npgo22/ThermoBoard/output/ThermoBoard.png

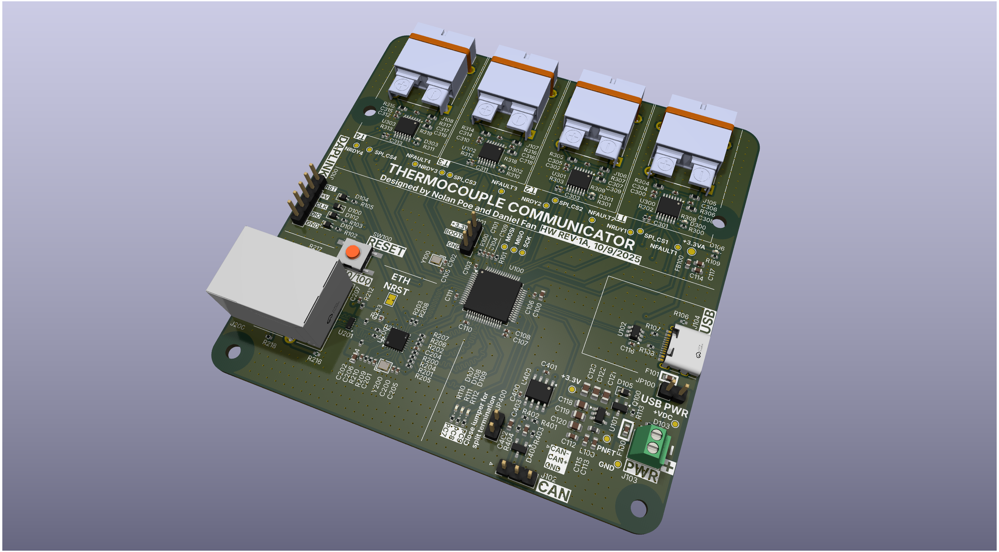
output/ThermoBoard.png
