npgo22/ThermoBoard/README

STATUS:
Initial decent layout and schematic are complete. PCB meets basic requirements.

TODO:
- Further review
