npgo22/ThermoBoard/output/ThermoBoard__Assembly.pdf

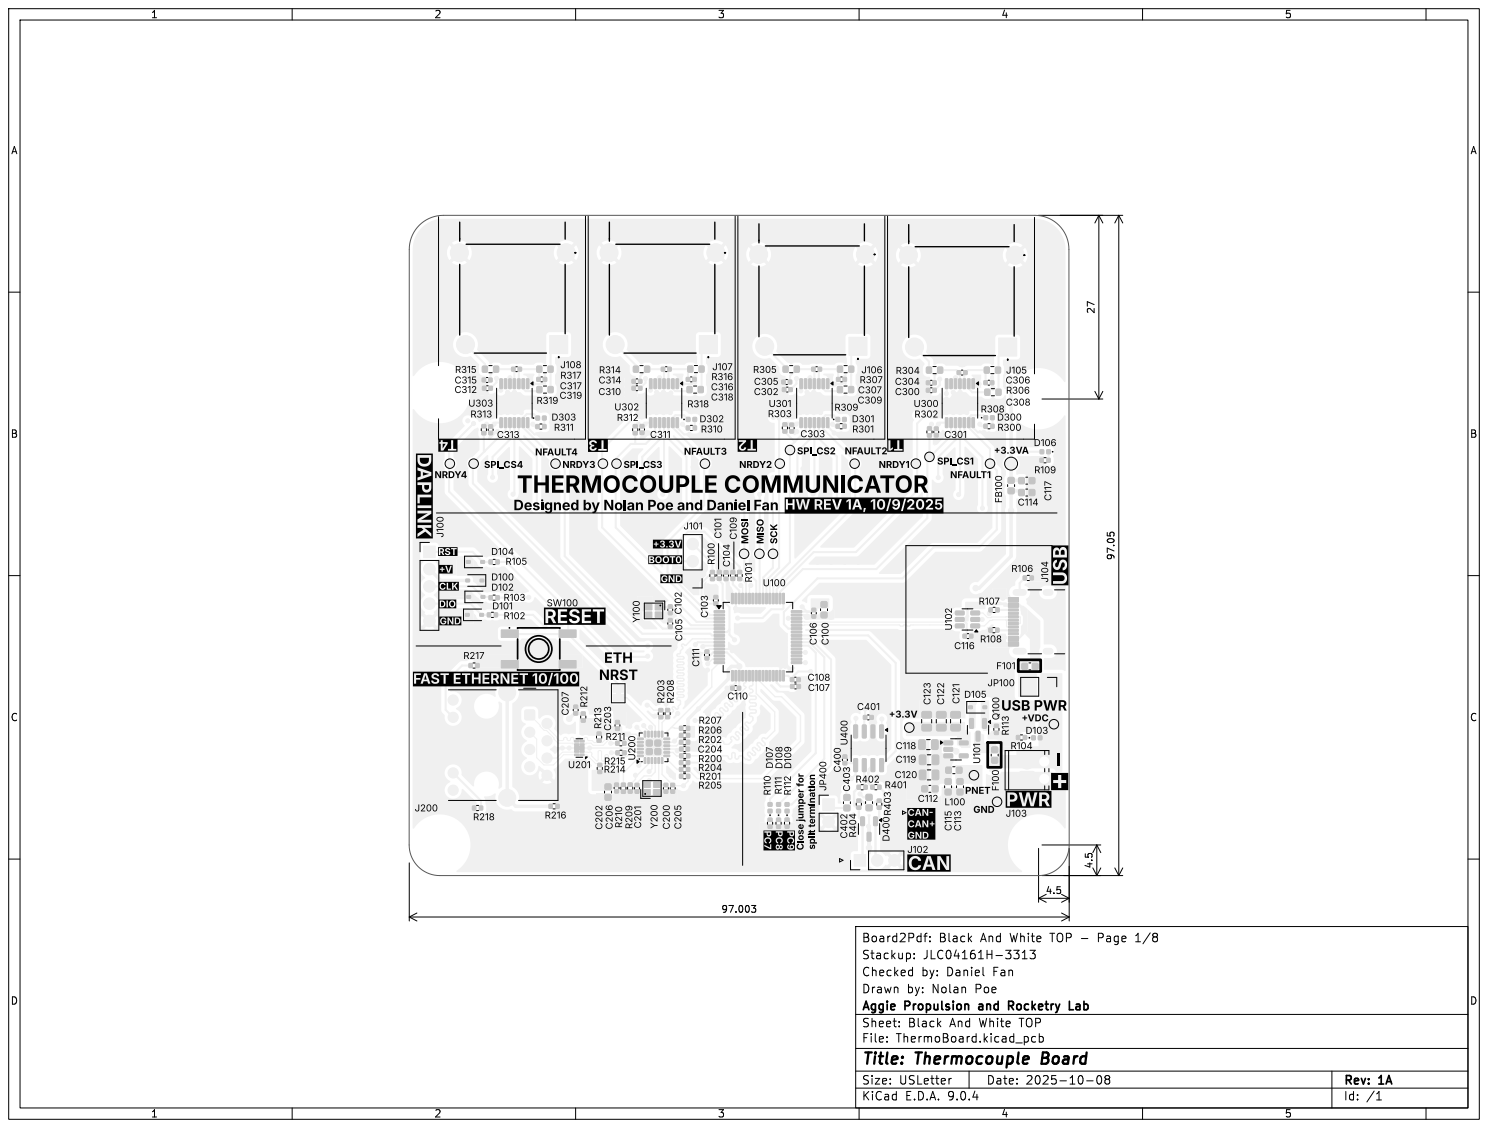
[picture p2: page 1]

THERMOCOUPLE COMMUNICATOR
Designed by Nolan Poe and Daniel Fan

+3.3V Close jumper for split termination

Id: /1 Title: Thermocouple Board

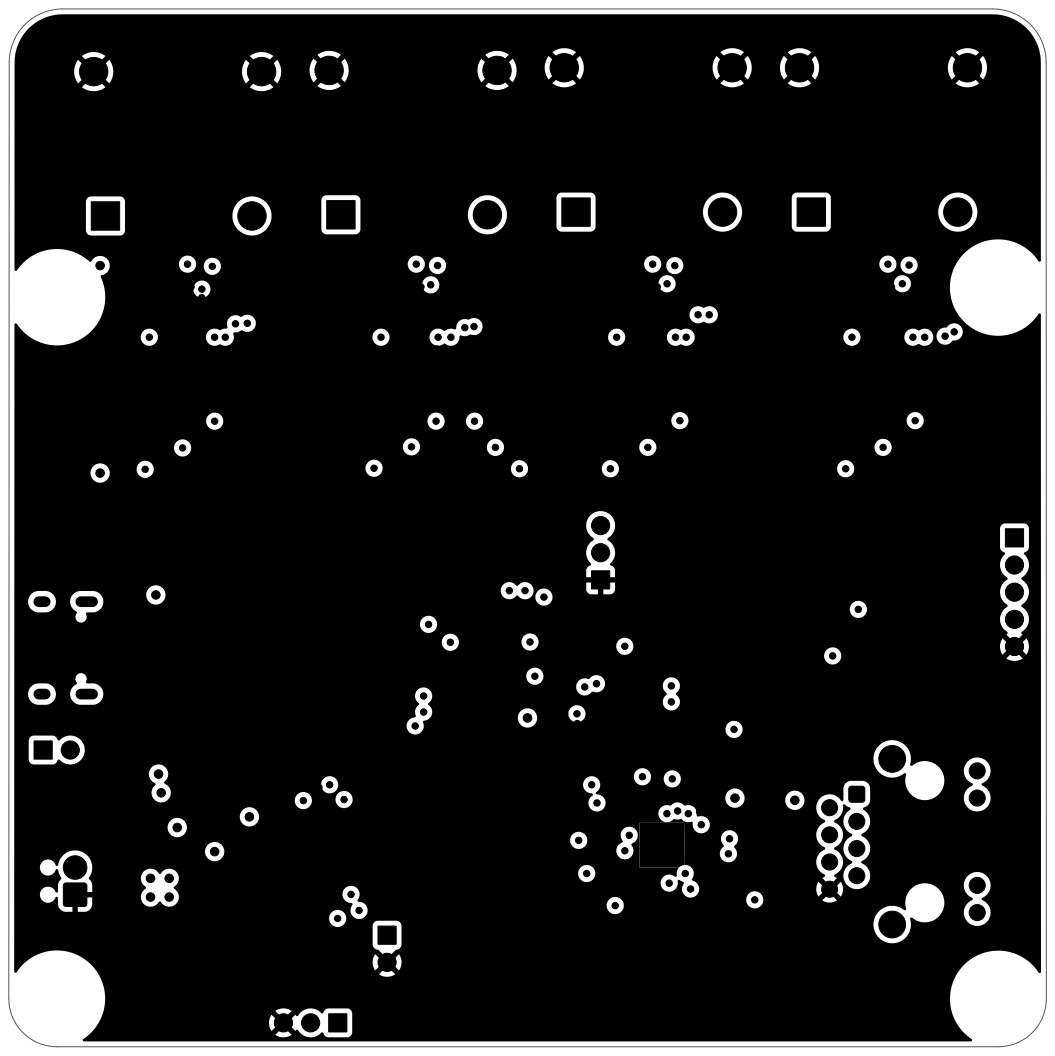
[picture p3: page 2]
D Date: 2025-10-08 KiCad; E.D.A. 9.0.4 Size: USLetter; Rev: 1A; File: ThermoBoard.kicad_pcb Sheet: Black; And; White; In1 Aggie; Propulsion and; Rocketry; Lab Drawn; Nolan; Poe Checked; Daniel; Fan Stackup:; JLC04161H-3313 Board2Pdf:; Black; Page 2/8

Id: /1 Title: Thermocouple Board

Id: /1 Title: Thermocouple Board

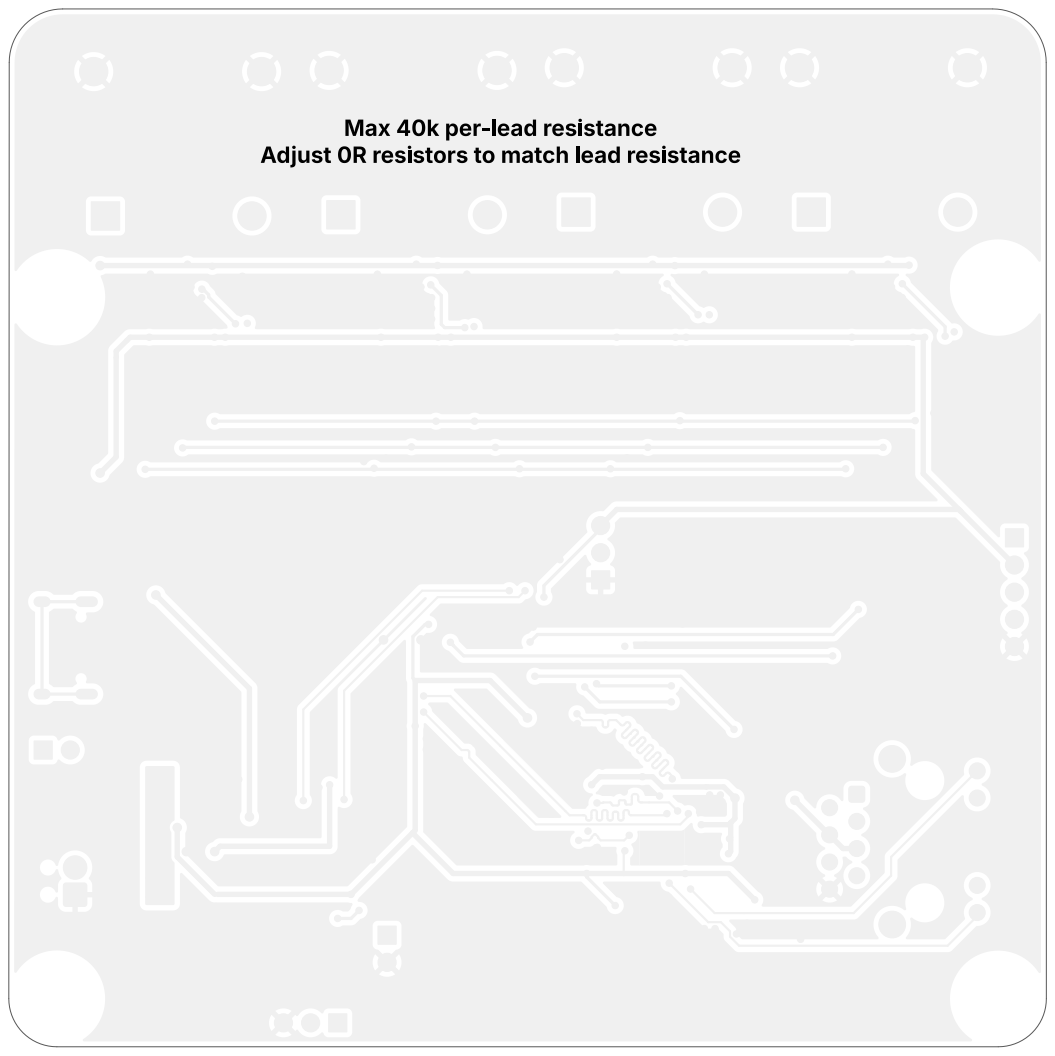
[picture p4: page 4]
D Date: 2025-10-08 KiCad; E.D.A. 9.0.4 Size: USLetter; Rev: 1A; File: ThermoBoard.kicad_pcb Sheet: Black; And; White; BOT Aggie; Propulsion and; Rocketry; Lab Drawn; Nolan; Poe Checked; Daniel; Fan Stackup:; JLC04161H-3313 Board2Pdf:; Black; BOT -; Page 4/8 Max 40k per-lead resistance; Adjust 0R resistors to match; lead resistance

Id: /1 Title: Thermocouple Board

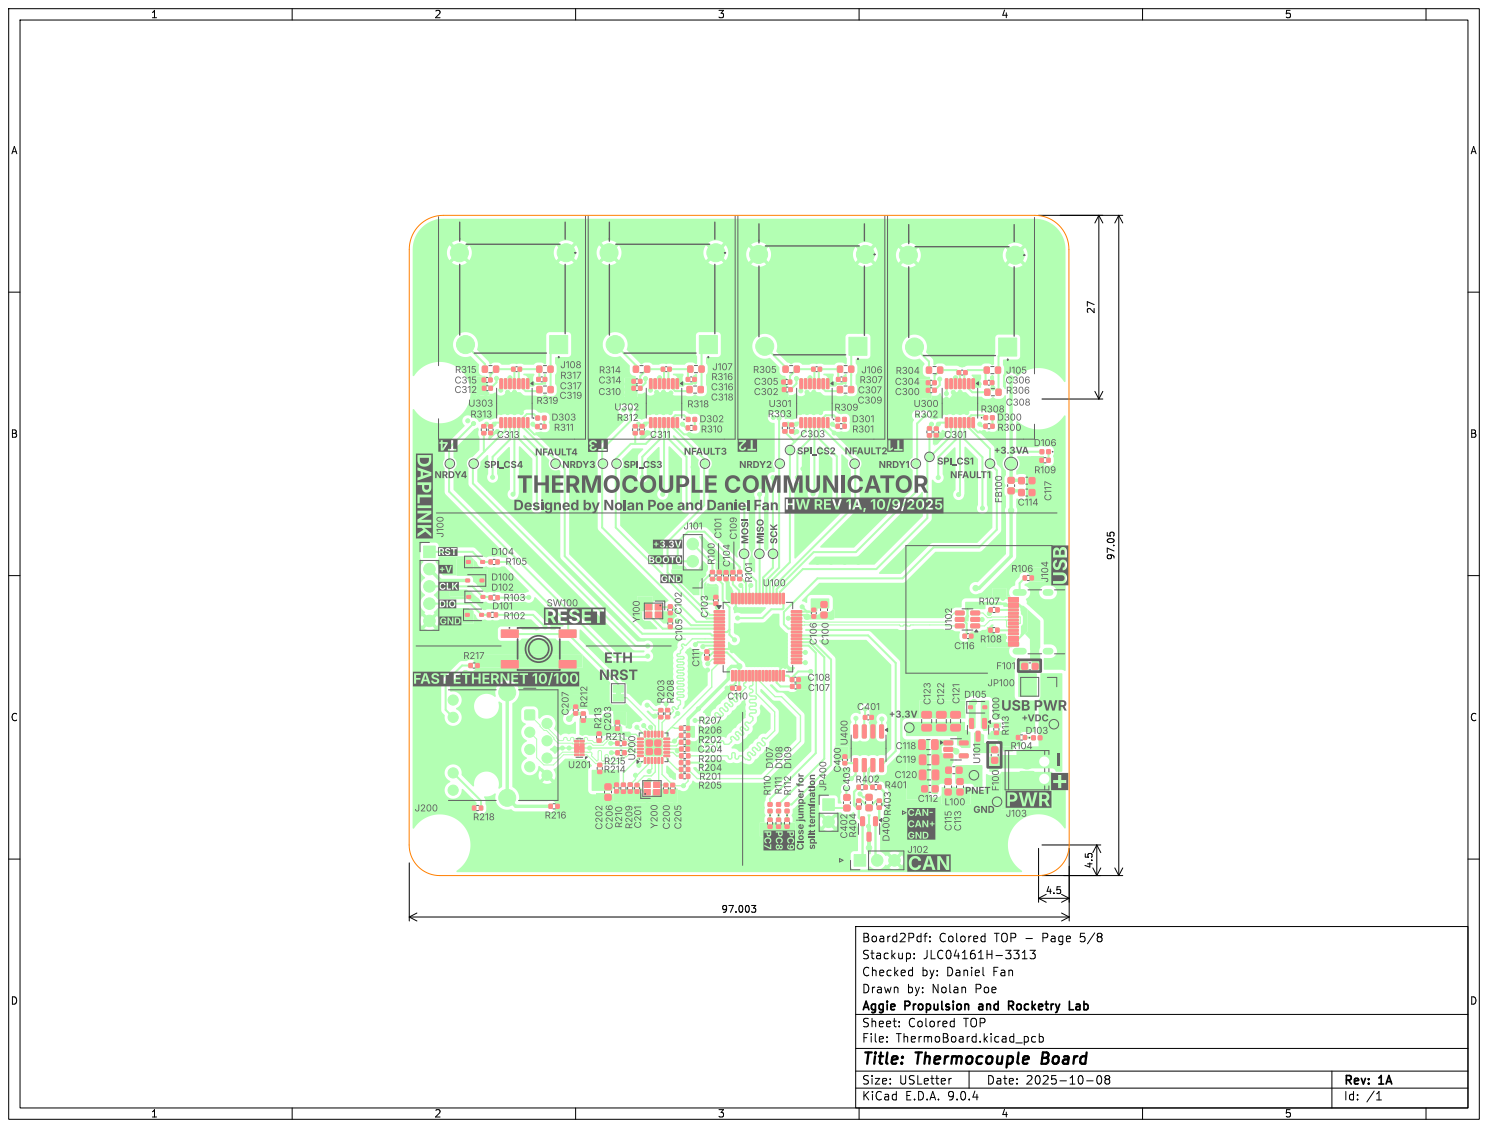
[picture p5: page 5]

THERMOCOUPLE COMMUNICATOR
Designed by Nolan Poe and Daniel Fan

+3.3V Close jumper for split termination

Id: /1 Title: Thermocouple Board

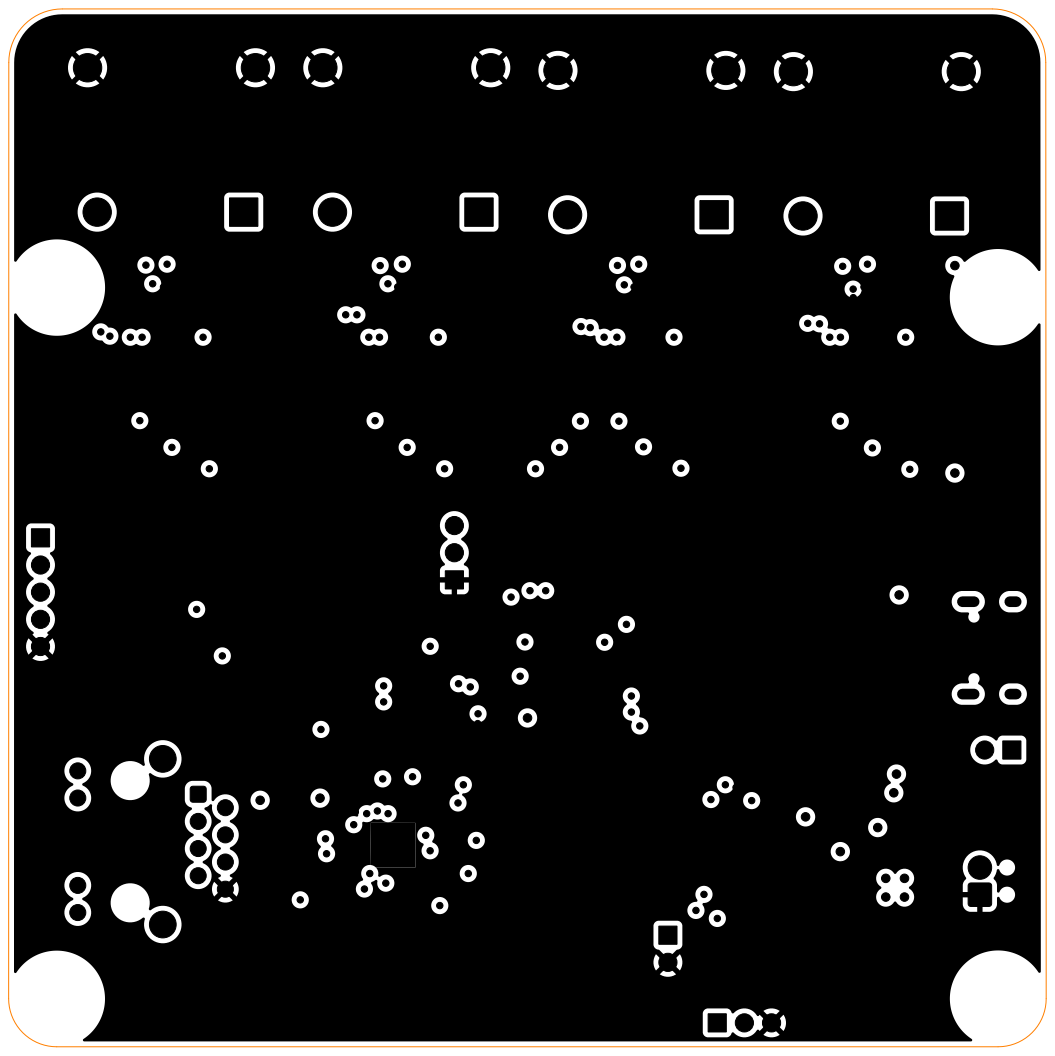
[picture p6: page 6]
D Date: 2025-10-08 KiCad; E.D.A. 9.0.4 Size: USLetter; Rev: 1A; File: ThermoBoard.kicad_pcb Sheet: Colored; In1 Aggie; Propulsion and; Rocketry; Lab Drawn; Nolan; Poe Checked; Daniel; Fan Stackup:; JLC04161H-3313 Board2Pdf:; Colored; Page 6/8

Id: /1 Title: Thermocouple Board

Id: /1 Title: Thermocouple Board

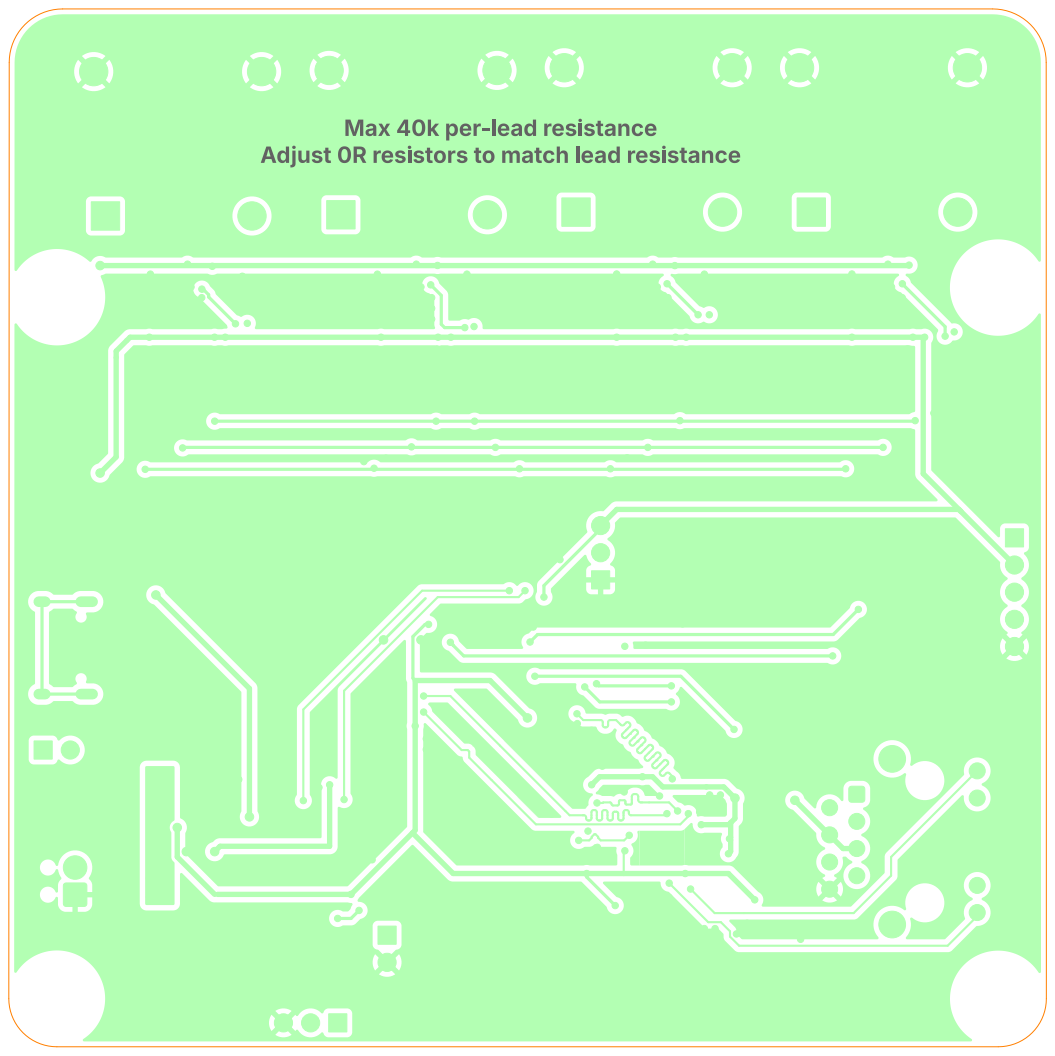
[picture p7: page 8]
D Date: 2025-10-08 KiCad; E.D.A. 9.0.4 Size: USLetter; Rev: 1A; File: ThermoBoard.kicad_pcb Sheet: Colored; BOT Aggie; Propulsion and; Rocketry; Lab Drawn; Nolan; Poe Checked; Daniel; Fan Stackup:; JLC04161H-3313 Board2Pdf:; Colored; BOT -; Page 8/8 Max 40k per-lead resistance; Adjust 0R resistors to match; lead resistance

Id: /1 Title: Thermocouple Board
