npgo22/ThermoBoard/output/ThermoBoard.pdf

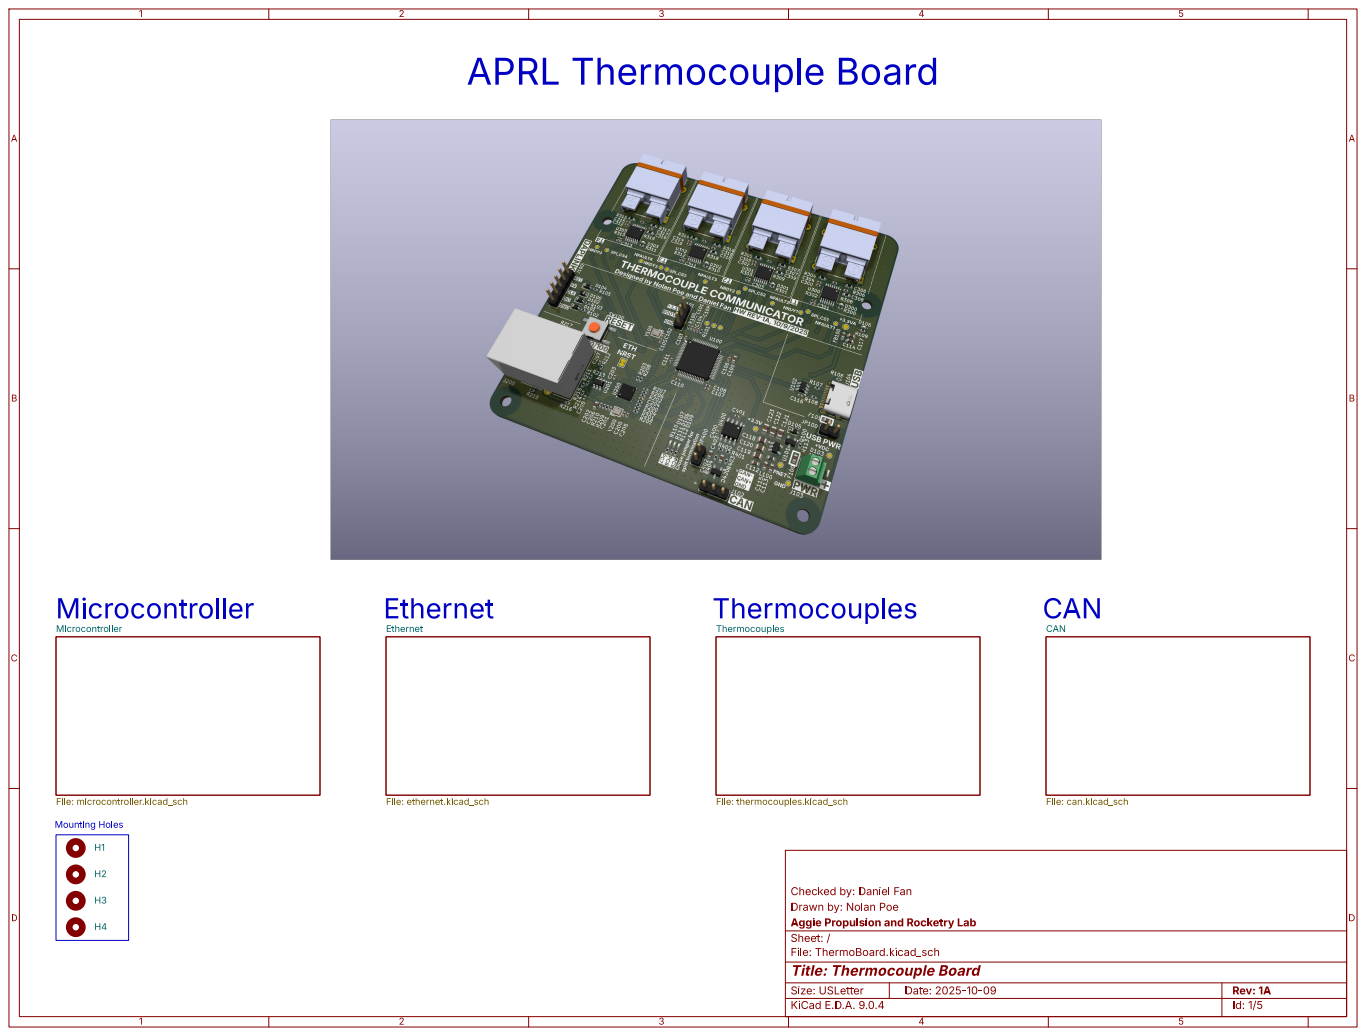
[picture p8: page 1]

Id: 1/5 Title: Thermocouple Board

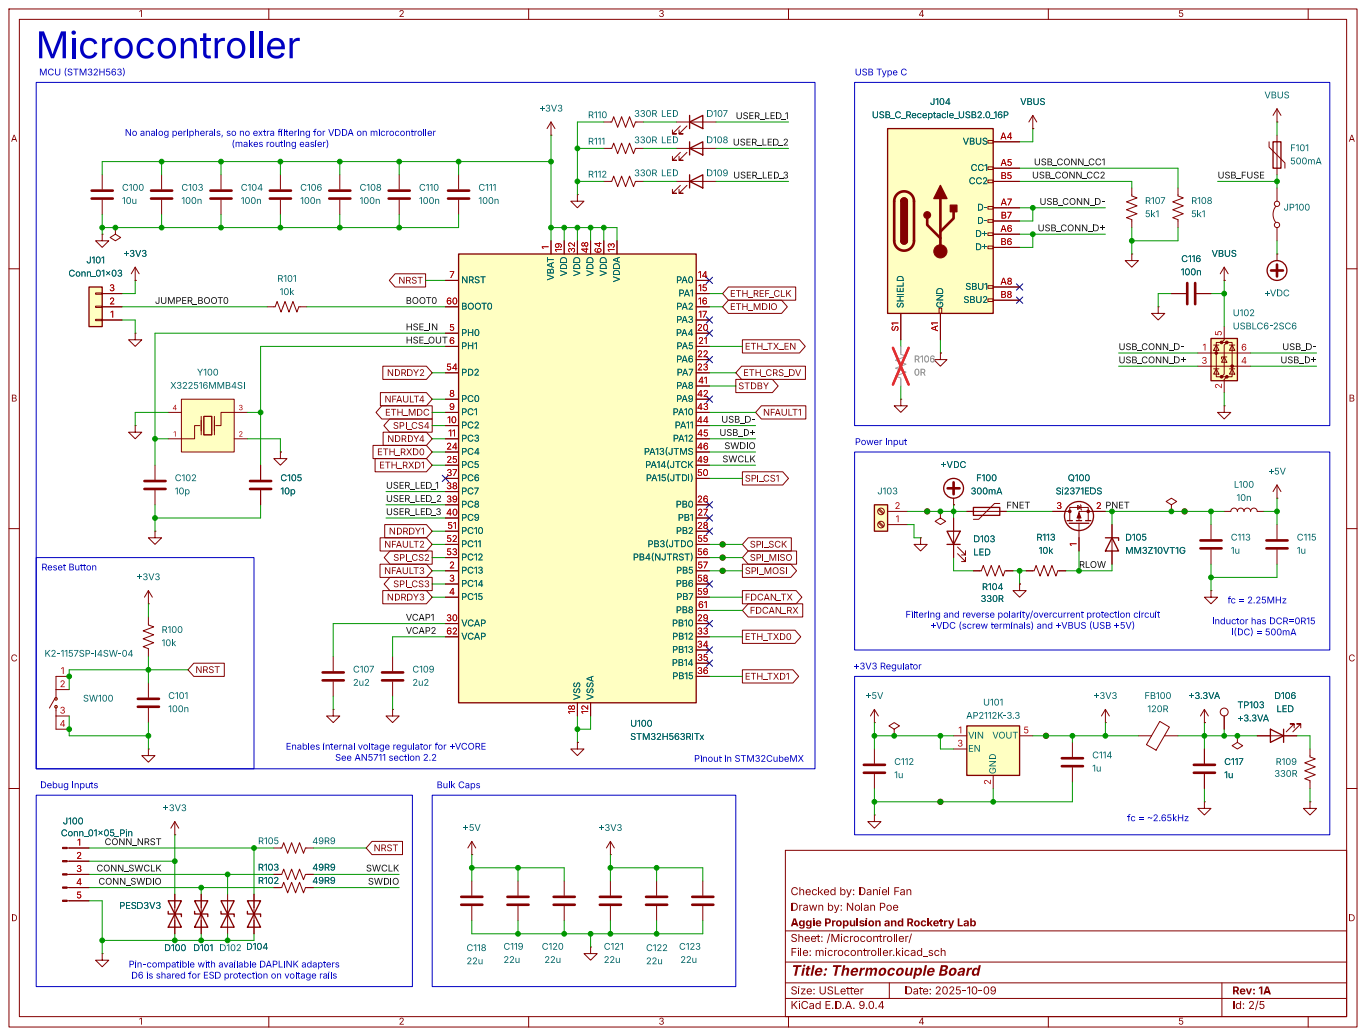
[picture p9: page 2]

No analog peripherals, so no extra filtering for VDDA on microcontroller

1 VDD 19 VDD 32 VSS 18 VDD 48 VSSA 12 VDD 64 VDDA 13 PA0

Power Input Reset Button Debug Inputs

Filtering and reverse polarity/overcurrent protection circuit +VDC (screw terminals) and +VBUS (USB +5V) Enables internal voltage regulator for +VCORE

Pin-compatible with available DAPLINK adapters D6 is shared for ESD protection on voltage rails

Id: 2/5 Title: Thermocouple Board

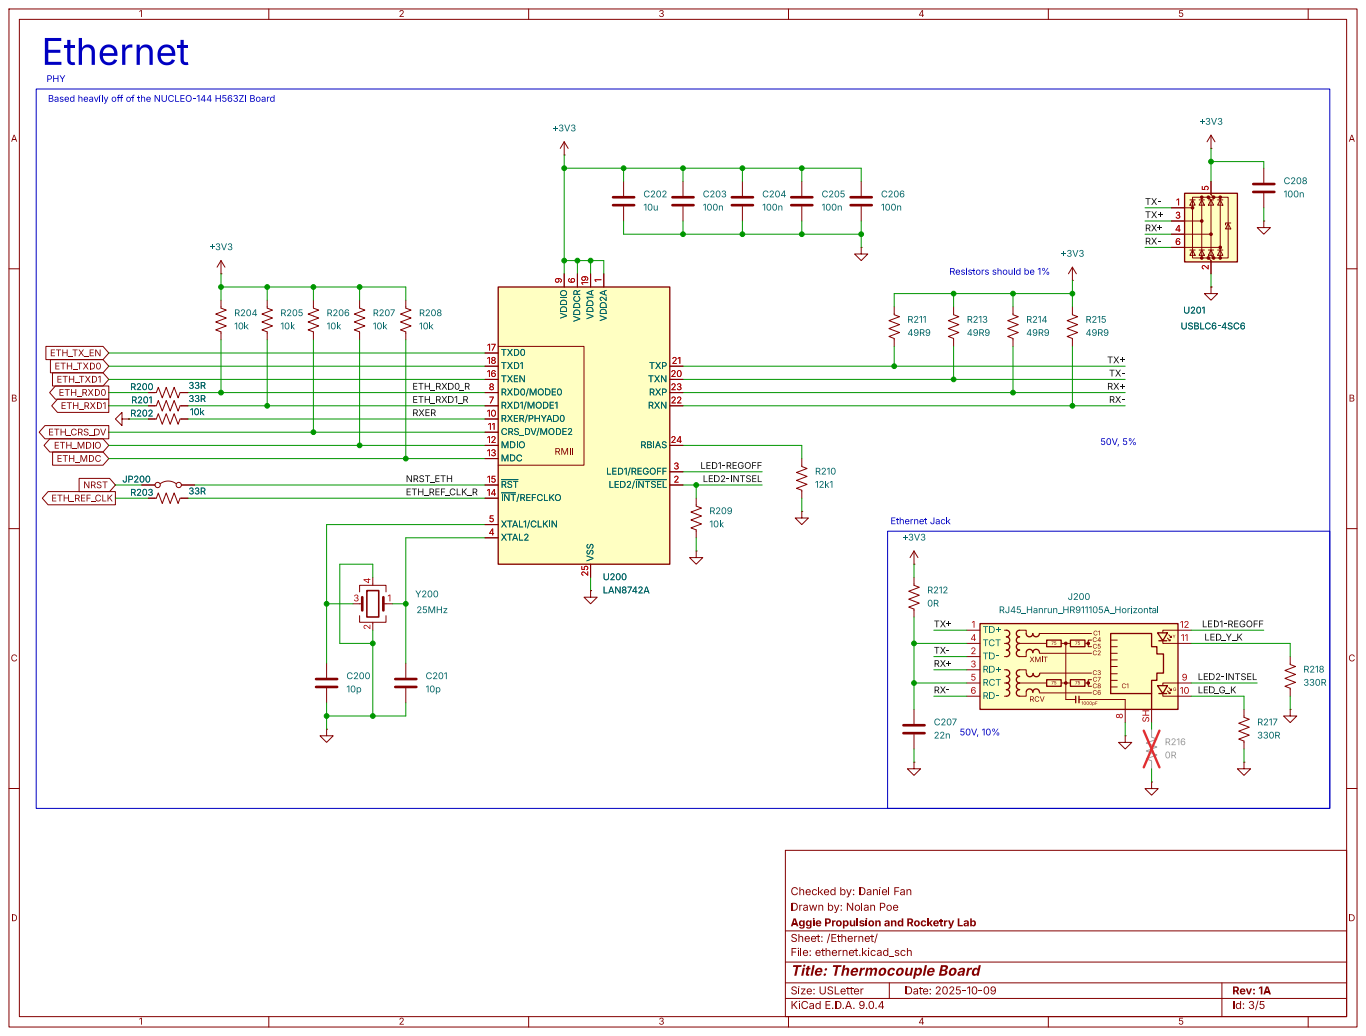
[picture p10: page 3]

Based heavily off of the NUCLEO-144 H563ZI Board

21 TXN
20 RXP 20 RXP 23 RXN 23 RXN

Id: 3/5 Title: Thermocouple Board

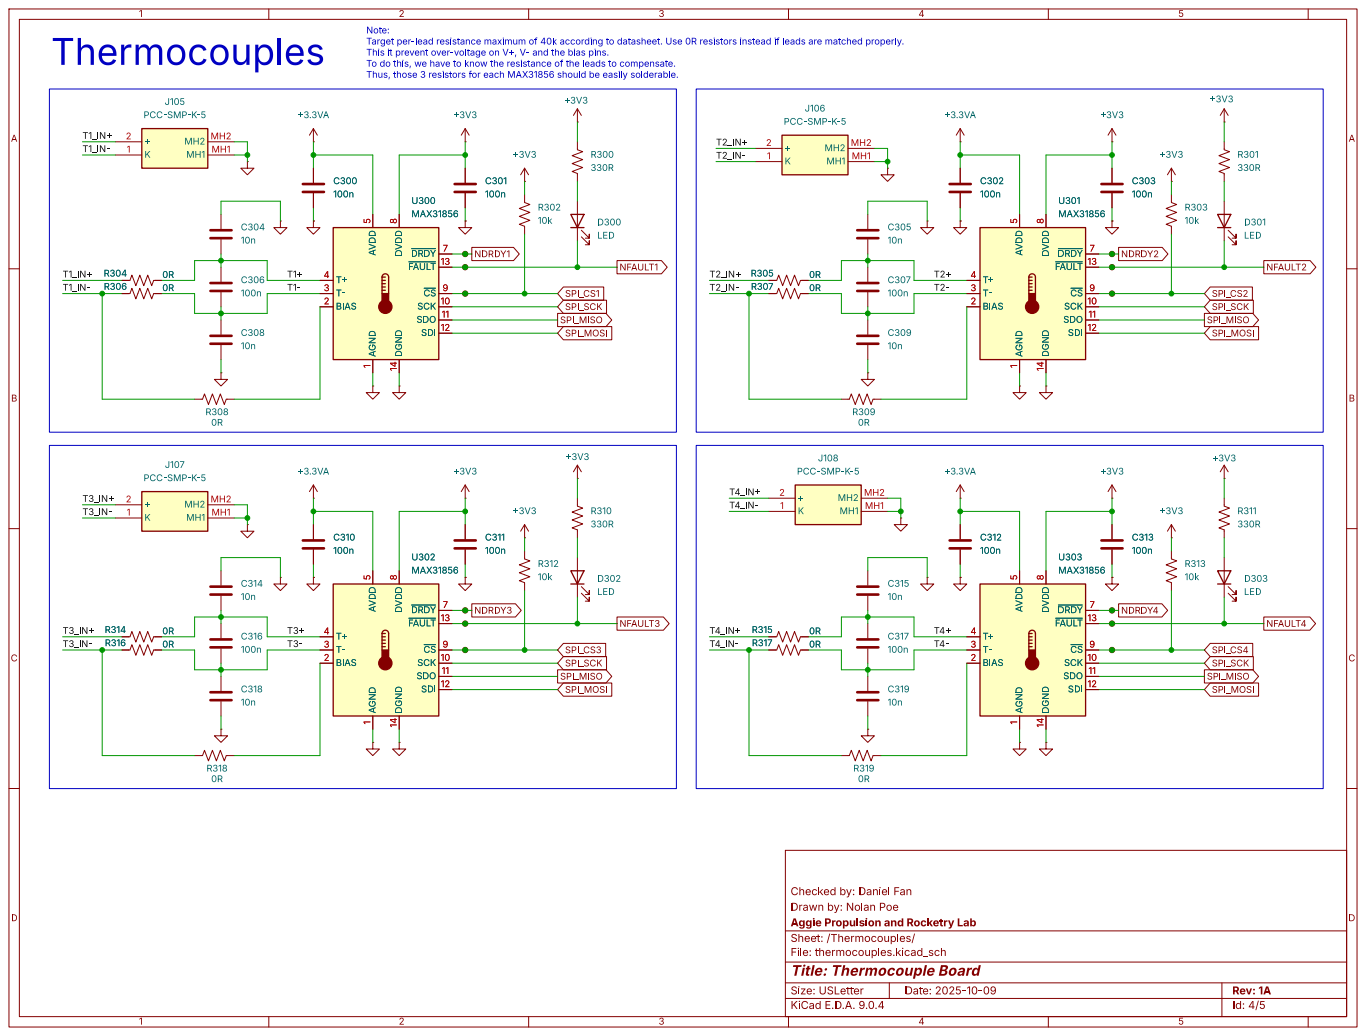
[picture p11: page 4]

~{DRDY}7 ~{FAULT} 13 ~{CS}9 SCK

File: thermocouples.kicad_sch Sheet: /Thermocouples/
Id: 4/5 Title: Thermocouple Board

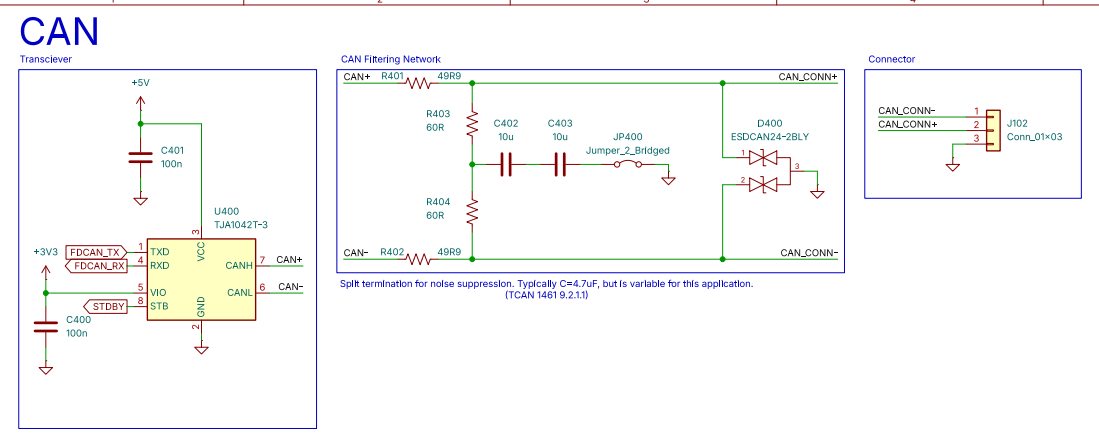
[picture p12: page 5]

Id: 5/5 Title: Thermocouple Board
