npgo22/ThermoBoard/ThermoBoard.kicad_pcb

## KiCad design ThermoBoard.kicad_pcb (2025-10-10)

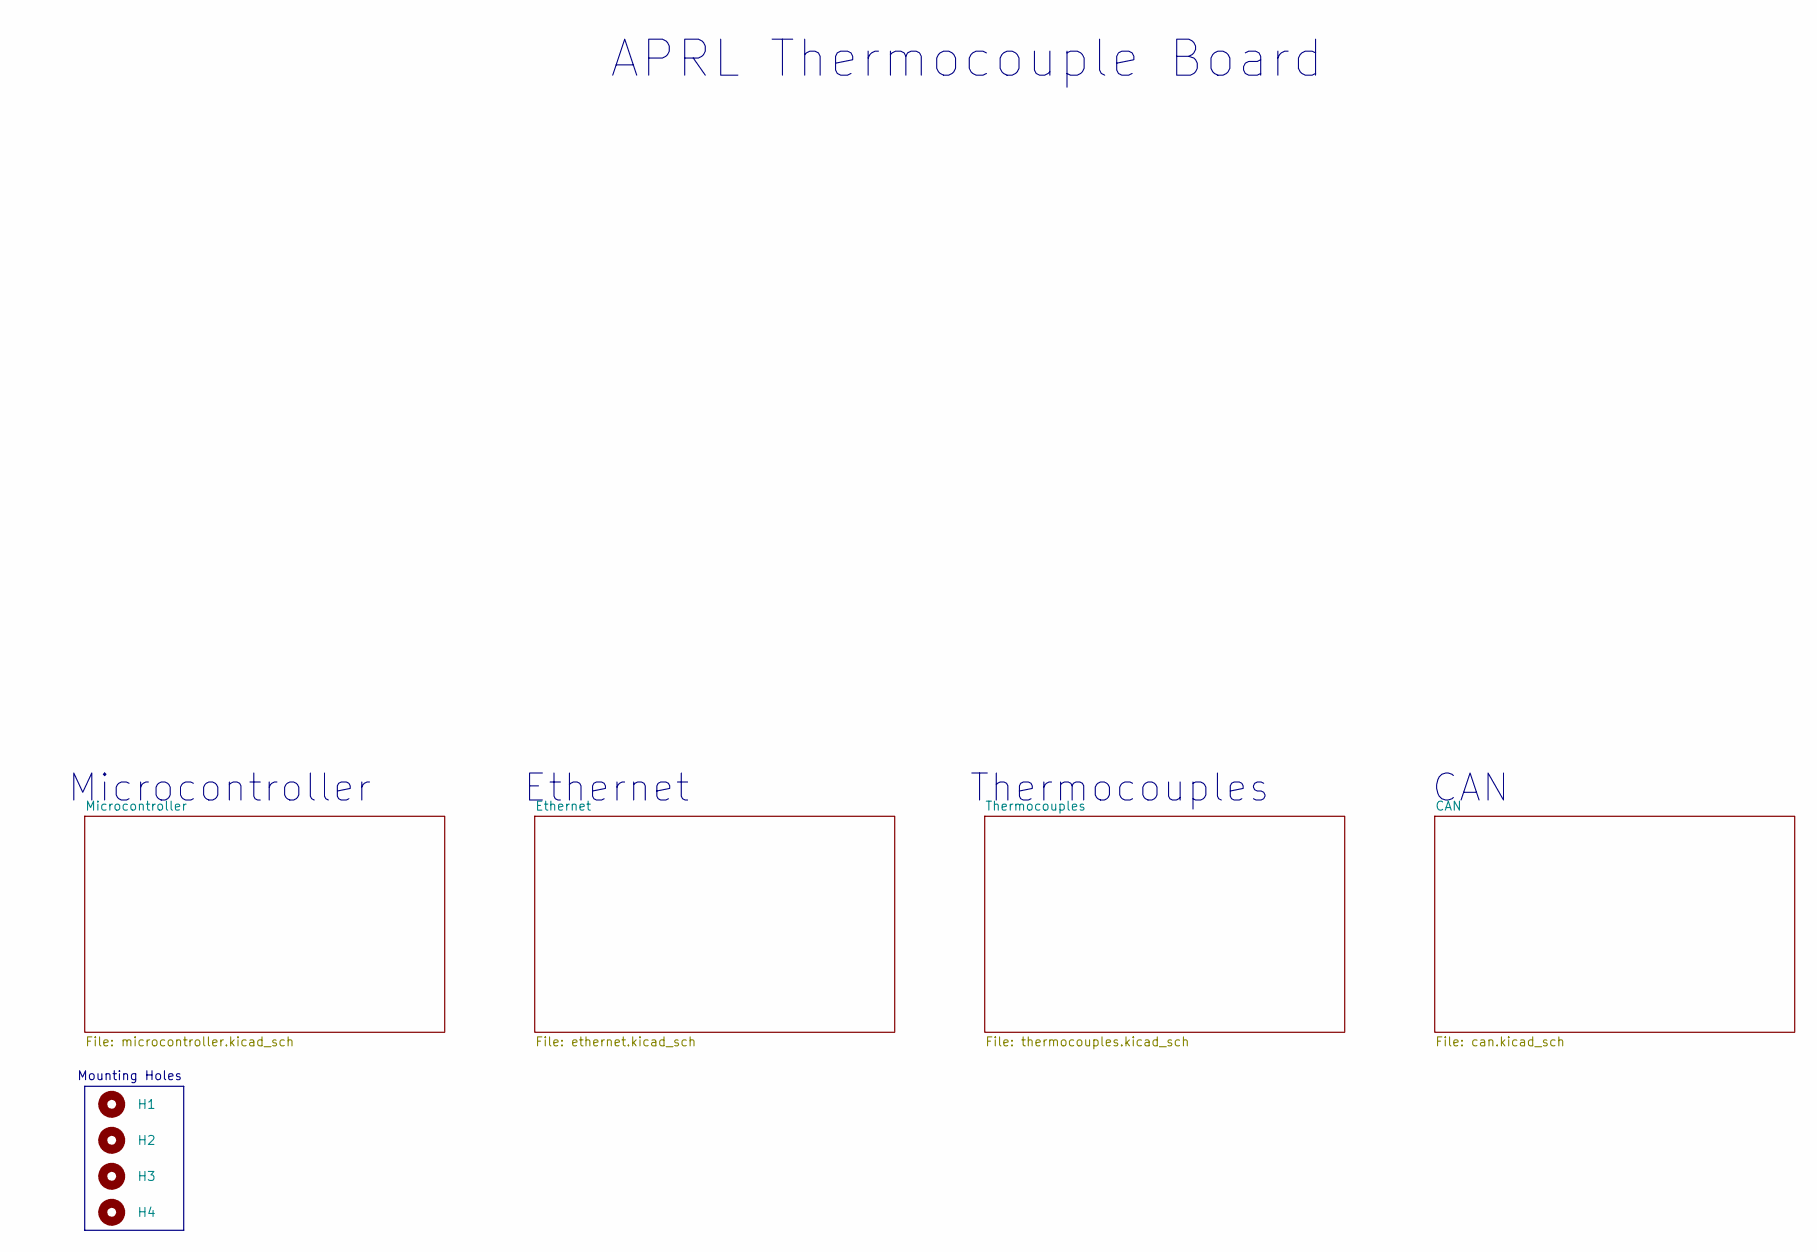
[picture p13: schematic ThermoBoard.kicad_sch, Thermocouple Board]

Parts:
H1, H2, H3, H4: MountingHole; MountingHole_3.2mm_M3

Notes on the sheet:
APRL Thermocouple Board
Mounting Holes
Thermocouples
Ethernet
Microcontroller
CAN

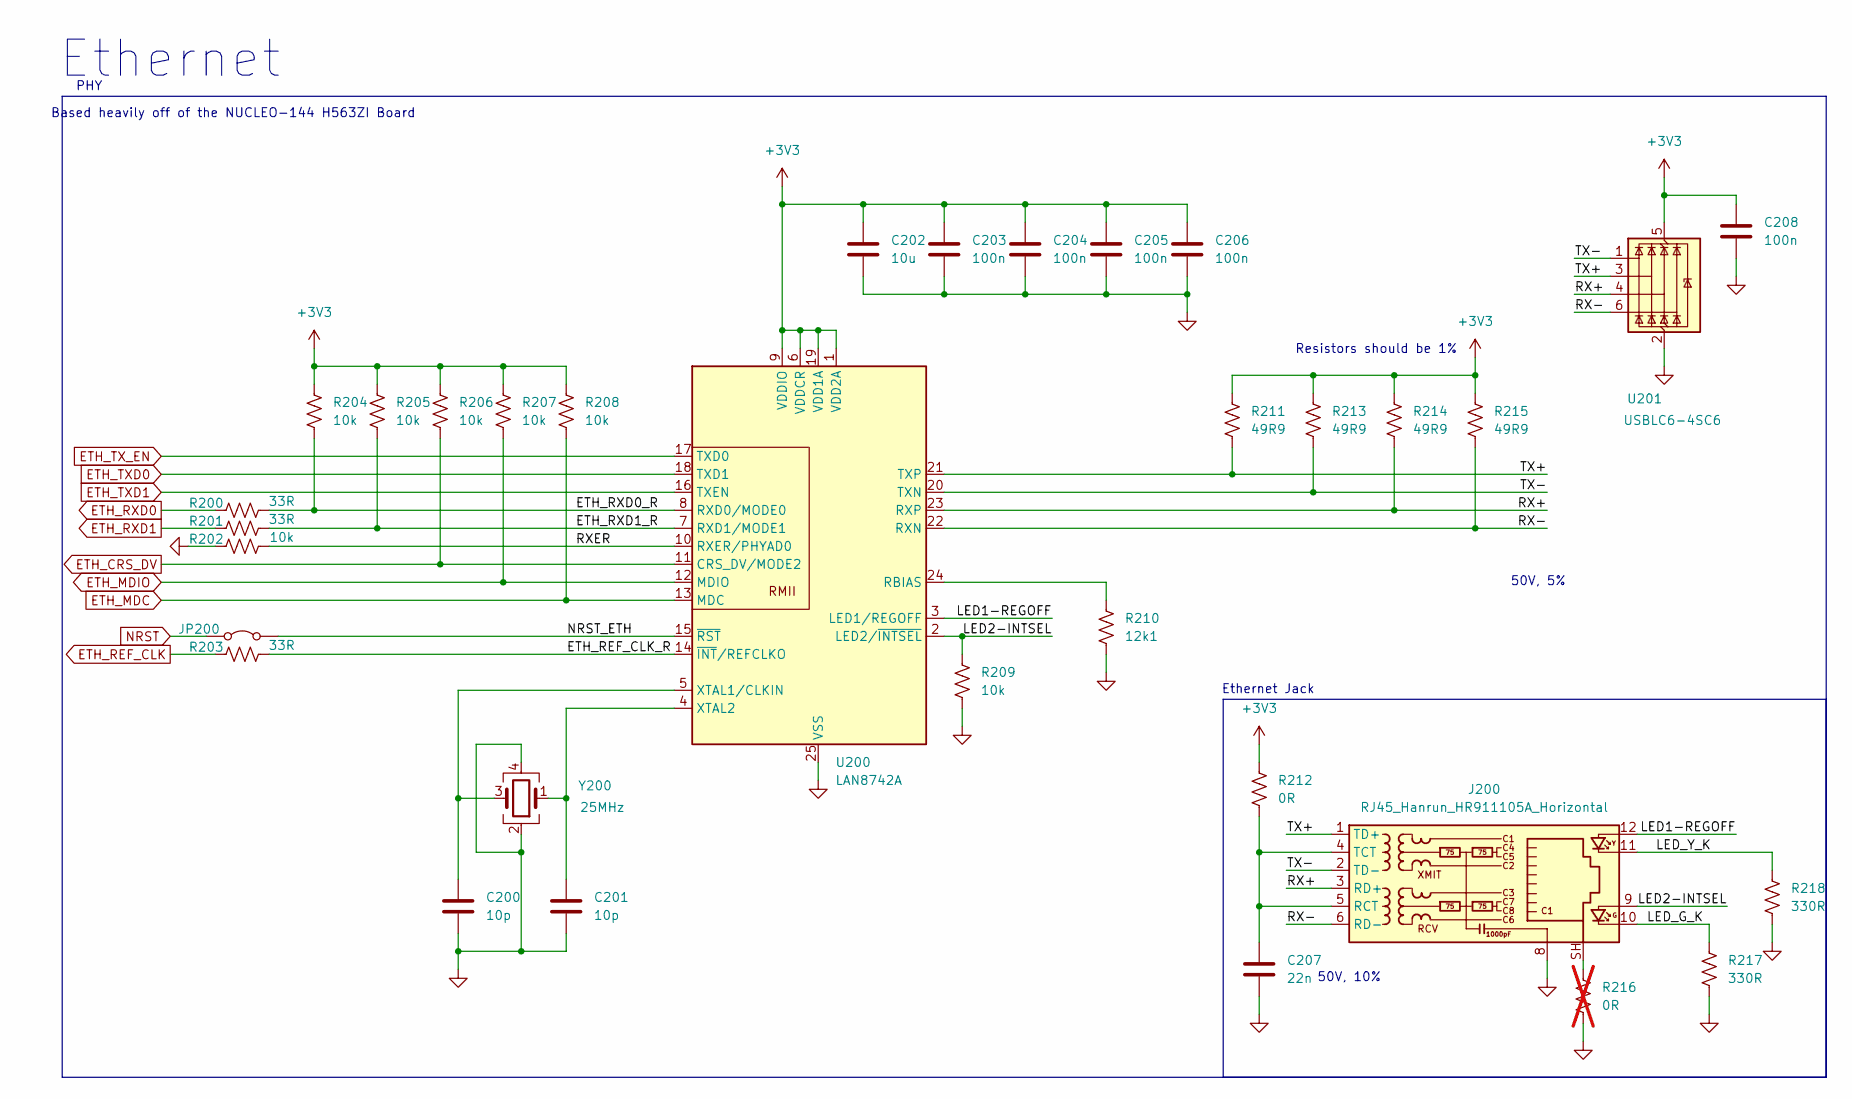
[picture p14: schematic ethernet.kicad_sch, Thermocouple Board]

Parts:
C200, C201: 10p; C_0402_1005Metric; LCSC C32949
C202: 10u; C_0603_1608Metric; LCSC C19702
C203, C204, C205, C206, C208: 100n; C_0402_1005Metric; LCSC C1525
C207: 22n; C_0402_1005Metric; LCSC C337699
J200: RJ45_Hanrun_HR911105A_Horizontal; LCSC C12074
JP200: Jumper_2_Bridged; SolderJumper-2_P1.3mm_Bridged_Pad1.0x1.5mm
R200, R201, R203: 33R; R_0402_1005Metric; LCSC C138002
R202, R204, R205, R206, R207, R208, R209: 10k; R_0402_1005Metric; LCSC C60490
R210: 12k1; R_0402_1005Metric; LCSC C25852
R211, R213, R214, R215: 49R9; R_0402_1005Metric; LCSC C87044
R212: 0R; R_0402_1005Metric; LCSC C106231
R216: 0R; R_0402_1005Metric; LCSC C106231; not fitted
R217, R218: 330R; R_0402_1005Metric; LCSC C105875
U200: LAN8742A; VQFN-24-1EP_4x4mm_P0.5mm_EP2.5x2.5mm_ThermalVias; LCSC C220794
U201: USBLC6-4SC6; SOT-23-6; LCSC C111212
Y200: 25MHz; CRYSTAL-SMD_4P-L2.0-W1.6-BL; LCSC C5765970

Connections:
+3V3: C202.1, C203.1, C204.1, C205.1, C206.1, C208.1, R204.1, R205.1, R206.1, R207.1, R208.1, R211.1, R212.1, R213.1, R214.1, R215.1, U200.1 (VDD2A), U200.6 (VDDCR), U200.9 (VDDIO), U200.19 (VDD1A), U201.5 (VBUS); also elsewhere on the board
/Ethernet/ETH_REF_CLK_R: R203.2, U200.14 (~INT/REFCLKO)
/Ethernet/ETH_RXD0_R: R200.2, R204.2, U200.8 (RXD0/MODE0)
/Ethernet/ETH_RXD1_R: R201.2, R205.2, U200.7 (RXD1/MODE1)
/Ethernet/LED1-REGOFF: J200.12, U200.3 (LED1/REGOFF)
/Ethernet/LED2-INTSEL: J200.9, R209.1, U200.2 (LED2/~INTSEL)
/Ethernet/LED_G_K: J200.10, R217.1
/Ethernet/LED_Y_K: J200.11, R218.1
/Ethernet/NRST_ETH: JP200.2 (B), U200.15 (~RST)
/Ethernet/RX+: J200.3 (RD+), R214.2, U200.23 (RXP), U201.4 (I/O3)
/Ethernet/RX-: J200.6 (RD-), R215.2, U200.22 (RXN), U201.6 (I/O4)
/Ethernet/RXER: R202.2, U200.10 (RXER/PHYAD0)
/Ethernet/TX+: J200.1 (TD+), R211.2, U200.21 (TXP), U201.3 (I/O2)
/Ethernet/TX-: J200.2 (TD-), R213.2, U200.20 (TXN), U201.1 (I/O1)
ETH_CRS_DV: R206.2, U200.11 (CRS_DV/MODE2); also elsewhere on the board
ETH_MDC: R208.2, U200.13 (MDC); also elsewhere on the board
ETH_MDIO: R207.2, U200.12 (MDIO); also elsewhere on the board
ETH_REF_CLK: R203.1; also elsewhere on the board
ETH_RXD0: R200.1; also elsewhere on the board
ETH_RXD1: R201.1; also elsewhere on the board
ETH_TXD0: U200.18 (TXD1); also elsewhere on the board
ETH_TXD1: U200.16 (TXEN); also elsewhere on the board
ETH_TX_EN: U200.17 (TXD0); also elsewhere on the board
GND: C200.2, C201.2, C202.2, C203.2, C204.2, C205.2, C206.2, C207.2, C208.2, J200.8, R202.1, R209.2, R210.2, R216.2, R217.2, R218.2, U200.25 (VSS), U201.2 (GND), Y200.2, Y200.4; also elsewhere on the board
NRST: JP200.1 (A); also elsewhere on the board
unnamed: J200.SH, R216.1
unnamed: C207.1, J200.4 (TCT), J200.5 (RCT), R212.2
unnamed: R210.1, U200.24 (RBIAS)
unnamed: C200.1, U200.5 (XTAL1/CLKIN), Y200.3
unnamed: C201.1, U200.4 (XTAL2), Y200.1

Notes on the sheet:
Based heavily off of the NUCLEO-144 H563ZI Board
Ethernet
Resistors should be 1%
Ethernet Jack
PHY
50V, 10%
50V, 5%

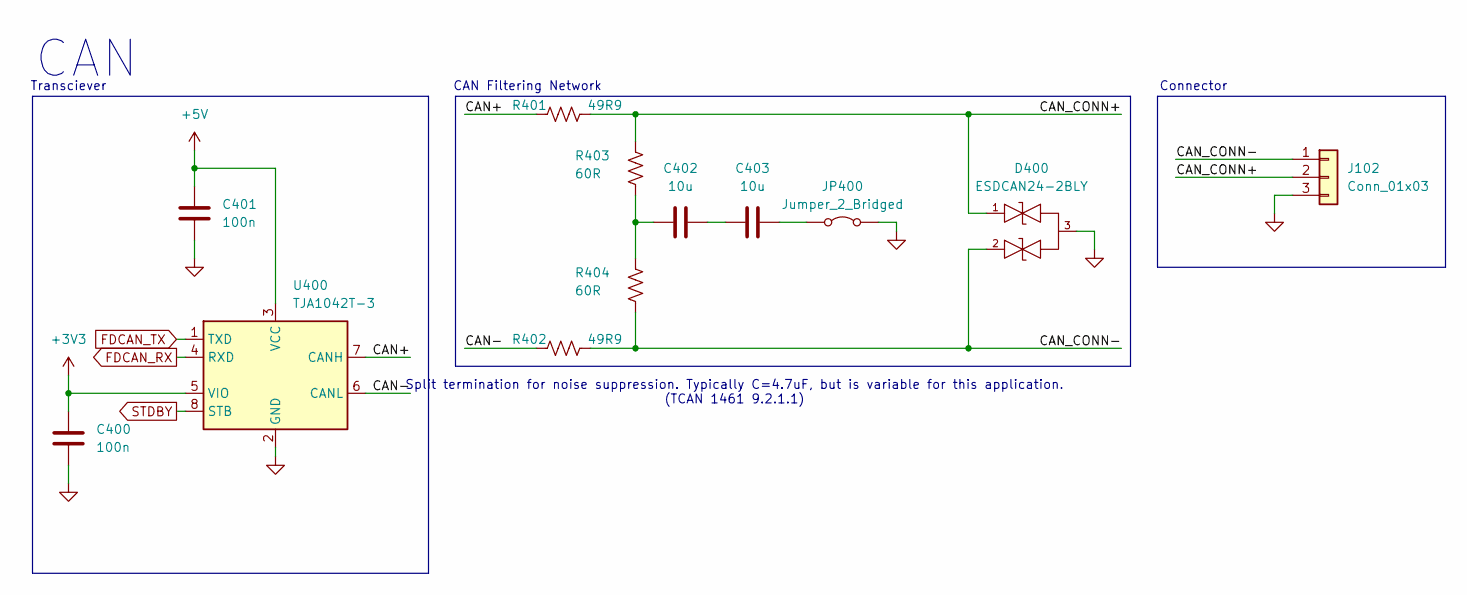
[picture p15: schematic can.kicad_sch, Thermocouple Board]

Parts:
C400, C401: 100n; C_0402_1005Metric; LCSC C1525
C402, C403: 10u; C_0603_1608Metric; LCSC C19702
D400: ESDCAN24-2BLY; SOT-23-3; LCSC C246766
J102: Conn_01x03; PinHeader_1x03_P2.54mm_Vertical; LCSC C2337
JP400: Jumper_2_Bridged; PinHeader_1x02_P2.54mm_Vertical; LCSC C2337
R401, R402: 49R9; R_0402_1005Metric; LCSC C87044
R403, R404: 60R; R_0402_1005Metric; LCSC C137954
U400: TJA1042T-3; SOIC-8_3.9x4.9mm_P1.27mm; LCSC C22445414

Connections:
+3V3: C400.1, U400.5 (VIO); also elsewhere on the board
+5V: C401.1, U400.3 (VCC); also elsewhere on the board
/CAN/CAN+: R401.1, U400.7 (CANH)
/CAN/CAN-: R402.1, U400.6 (CANL)
/CAN/CAN_CONN+: D400.1, J102.2, R401.2, R403.1
/CAN/CAN_CONN-: D400.2, J102.1, R402.2, R404.2
FDCAN_RX: U400.4 (RXD); also elsewhere on the board
FDCAN_TX: U400.1 (TXD); also elsewhere on the board
GND: C400.2, C401.2, D400.3, J102.3, JP400.2 (B), U400.2 (GND); also elsewhere on the board
unnamed: C402.1, R403.2, R404.1
unnamed: C402.2, C403.2
unnamed: C403.1, JP400.1 (A)
STDBY: U400.8 (STB); also elsewhere on the board

Notes on the sheet:
Split termination for noise suppression. Typically C=4.7uF, but is variable for this application. (TCAN 1461 9.2.1.1)
CAN
Transciever
CAN Filtering Network
Connector

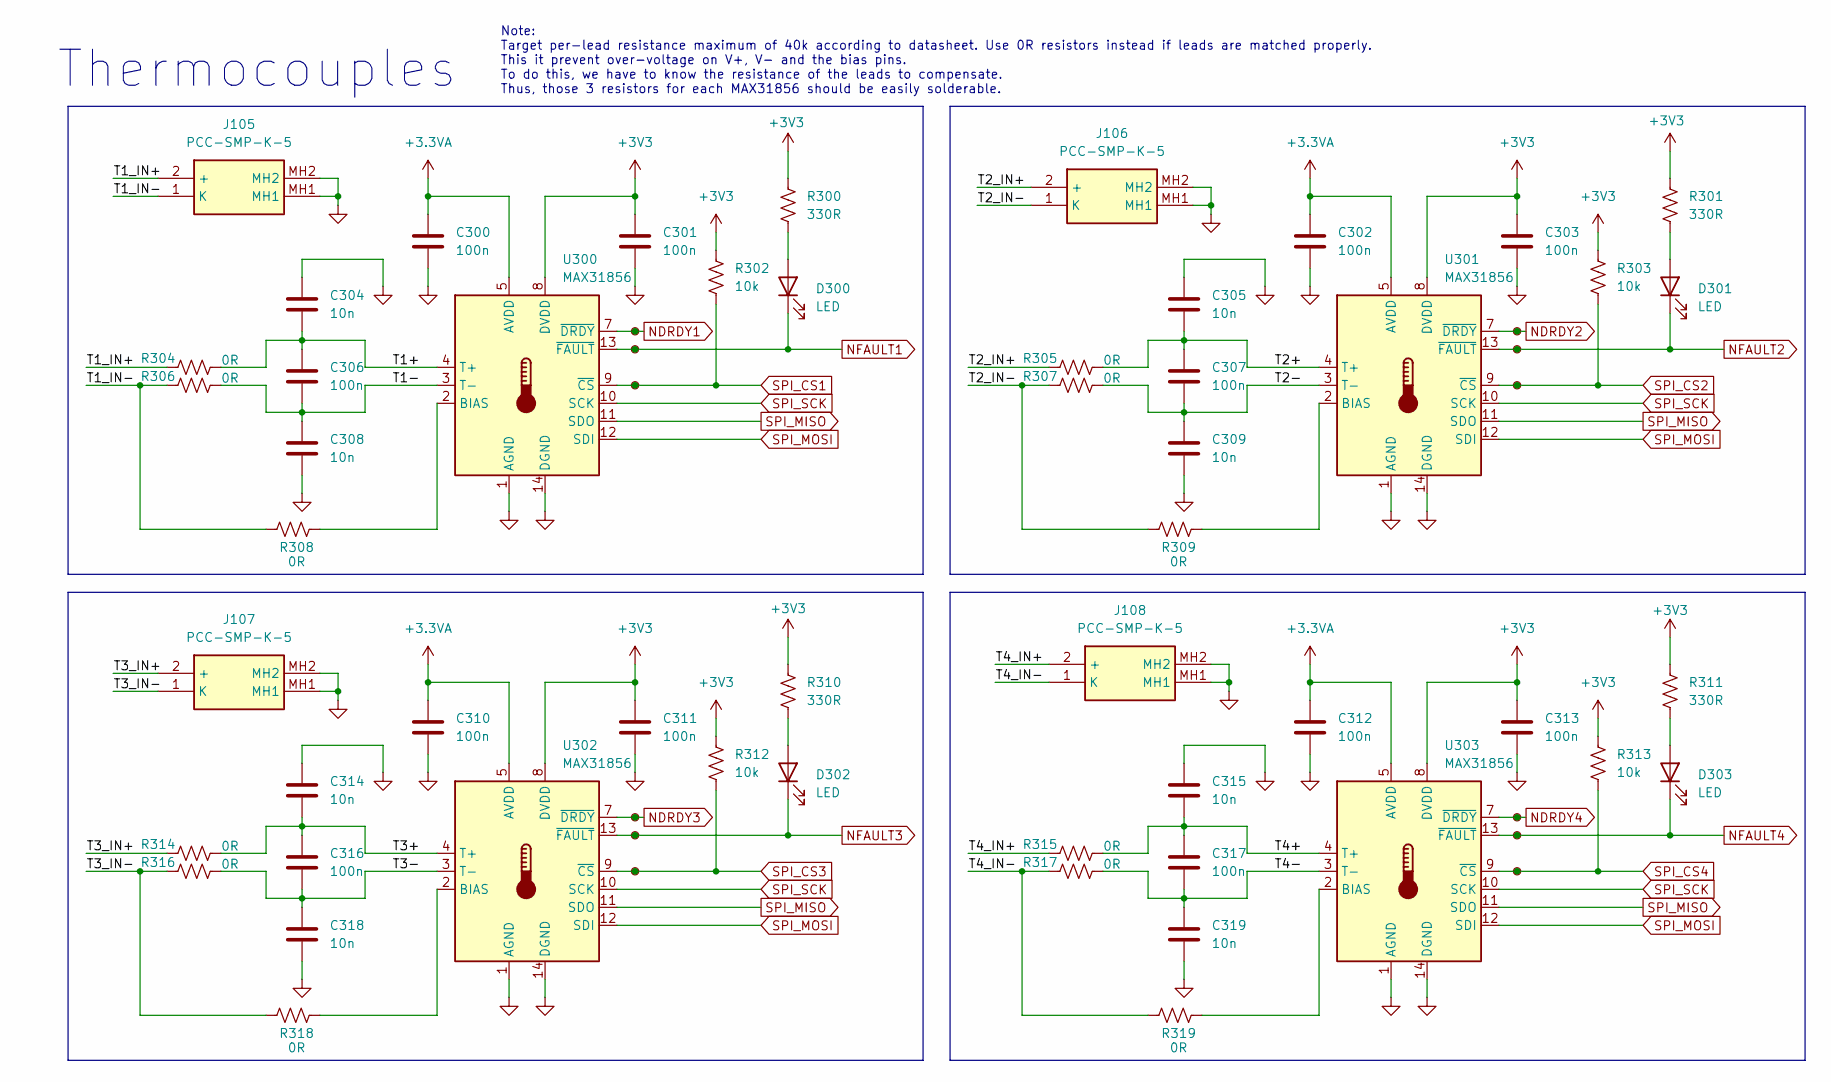
[picture p16: schematic thermocouples.kicad_sch, Thermocouple Board]

Parts:
C300, C301, C302, C303, C306, C307, C310, C311, C312, C313, C316, C317: 100n; C_0402_1005Metric; LCSC C1525
C304, C305, C308, C309, C314, C315, C318, C319: 10n; C_0402_1005Metric; LCSC C15195
D300, D301, D302, D303: LED; LED_0402_1005Metric; LCSC C965793
J105, J106, J107, J108: PCC-SMP-K-5; PCCSMPK5; Manufacturer_Part_Number PCC-SMP-K-5
R300, R301, R310, R311: 330R; R_0402_1005Metric; LCSC C105875
R302, R303, R312, R313: 10k; R_0402_1005Metric; LCSC C60490
R304, R305, R306, R307, R308, R309, R314, R315, R316, R317, R318, R319: 0R; R_0603_1608Metric; LCSC C95177
TP106, TP107, TP108, TP109, TP110, TP114, TP115, TP116, TP120, TP121, TP122, TP300: TestPoint_Small; TestPoint_Pad_D1.0mm
U300, U301, U302, U303: MAX31856; TSSOP-14_4.4x5mm_P0.65mm; LCSC C2653162

Connections:
+3.3VA: C300.1, C302.1, C310.1, C312.1, U300.5 (AVDD), U301.5 (AVDD), U302.5 (AVDD), U303.5 (AVDD); also elsewhere on the board
+3V3: C301.1, C303.1, C311.1, C313.1, R300.1, R301.1, R302.1, R303.1, R310.1, R311.1, R312.1, R313.1, U300.8 (DVDD), U301.8 (DVDD), U302.8 (DVDD), U303.8 (DVDD); also elsewhere on the board
/Thermocouples/T1+: C304.2, C306.1, R304.2, U300.4 (T+)
/Thermocouples/T1-: C306.2, C308.1, R306.2, U300.3 (T-)
/Thermocouples/T1_IN+: J105.2 (+), R304.1
/Thermocouples/T1_IN-: J105.1 (K), R306.1, R308.1
/Thermocouples/T2+: C305.2, C307.1, R305.2, U301.4 (T+)
/Thermocouples/T2-: C307.2, C309.1, R307.2, U301.3 (T-)
/Thermocouples/T2_IN+: J106.2 (+), R305.1
/Thermocouples/T2_IN-: J106.1 (K), R307.1, R309.1
/Thermocouples/T3+: C314.2, C316.1, R314.2, U302.4 (T+)
/Thermocouples/T3-: C316.2, C318.1, R316.2, U302.3 (T-)
/Thermocouples/T3_IN+: J107.2 (+), R314.1
/Thermocouples/T3_IN-: J107.1 (K), R316.1, R318.1
/Thermocouples/T4+: C315.2, C317.1, R315.2, U303.4 (T+)
/Thermocouples/T4-: C317.2, C319.1, R317.2, U303.3 (T-)
/Thermocouples/T4_IN+: J108.2 (+), R315.1
/Thermocouples/T4_IN-: J108.1 (K), R317.1, R319.1
GND: C300.2, C301.2, C302.2, C303.2, C304.1, C305.1, C308.2, C309.2, C310.2, C311.2, C312.2, C313.2, C314.1, C315.1, C318.2, C319.2, J105.MH1, J105.MH2, J106.MH1, J106.MH2, J107.MH1, J107.MH2, J108.MH1, J108.MH2, U300.1 (AGND), U300.14 (DGND), U301.1 (AGND), U301.14 (DGND), U302.1 (AGND), U302.14 (DGND), U303.1 (AGND), U303.14 (DGND); also elsewhere on the board
NDRDY1: TP106.1, U300.7 (~DRDY); also elsewhere on the board
NDRDY2: TP114.1, U301.7 (~DRDY); also elsewhere on the board
NDRDY3: TP108.1, U302.7 (~DRDY); also elsewhere on the board
NDRDY4: TP120.1, U303.7 (~DRDY); also elsewhere on the board
NFAULT1: D300.1 (K), TP107.1, U300.13 (~FAULT); also elsewhere on the board
NFAULT2: D301.1 (K), TP115.1, U301.13 (~FAULT); also elsewhere on the board
NFAULT3: D302.1 (K), TP109.1, U302.13 (~FAULT); also elsewhere on the board
NFAULT4: D303.1 (K), TP121.1, U303.13 (~FAULT); also elsewhere on the board
unnamed: D300.2 (A), R300.2
unnamed: D301.2 (A), R301.2
unnamed: D302.2 (A), R310.2
unnamed: D303.2 (A), R311.2
unnamed: R308.2, U300.2 (BIAS)
unnamed: R309.2, U301.2 (BIAS)
unnamed: R318.2, U302.2 (BIAS)
unnamed: R319.2, U303.2 (BIAS)
SPI_CS1: R302.2, TP300.1, U300.9 (~CS); also elsewhere on the board
SPI_CS2: R303.2, TP116.1, U301.9 (~CS); also elsewhere on the board
SPI_CS3: R312.2, TP110.1, U302.9 (~CS); also elsewhere on the board
SPI_CS4: R313.2, TP122.1, U303.9 (~CS); also elsewhere on the board
SPI_MISO: U300.11 (SDO), U301.11 (SDO), U302.11 (SDO), U303.11 (SDO); also elsewhere on the board
SPI_MOSI: U300.12 (SDI), U301.12 (SDI), U302.12 (SDI), U303.12 (SDI); also elsewhere on the board
SPI_SCK: U300.10 (SCK), U301.10 (SCK), U302.10 (SCK), U303.10 (SCK); also elsewhere on the board

Notes on the sheet:
Note: Target per-lead resistance maximum of 40k according to datasheet. Use 0R resistors instead if leads are matched properly. This it prevent over-voltage on V+, V- and the bias pins. To do this, we have to know the resistance of the leads to compensate. Thus, those 3 resistors for each MAX31856 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
Thermocouples

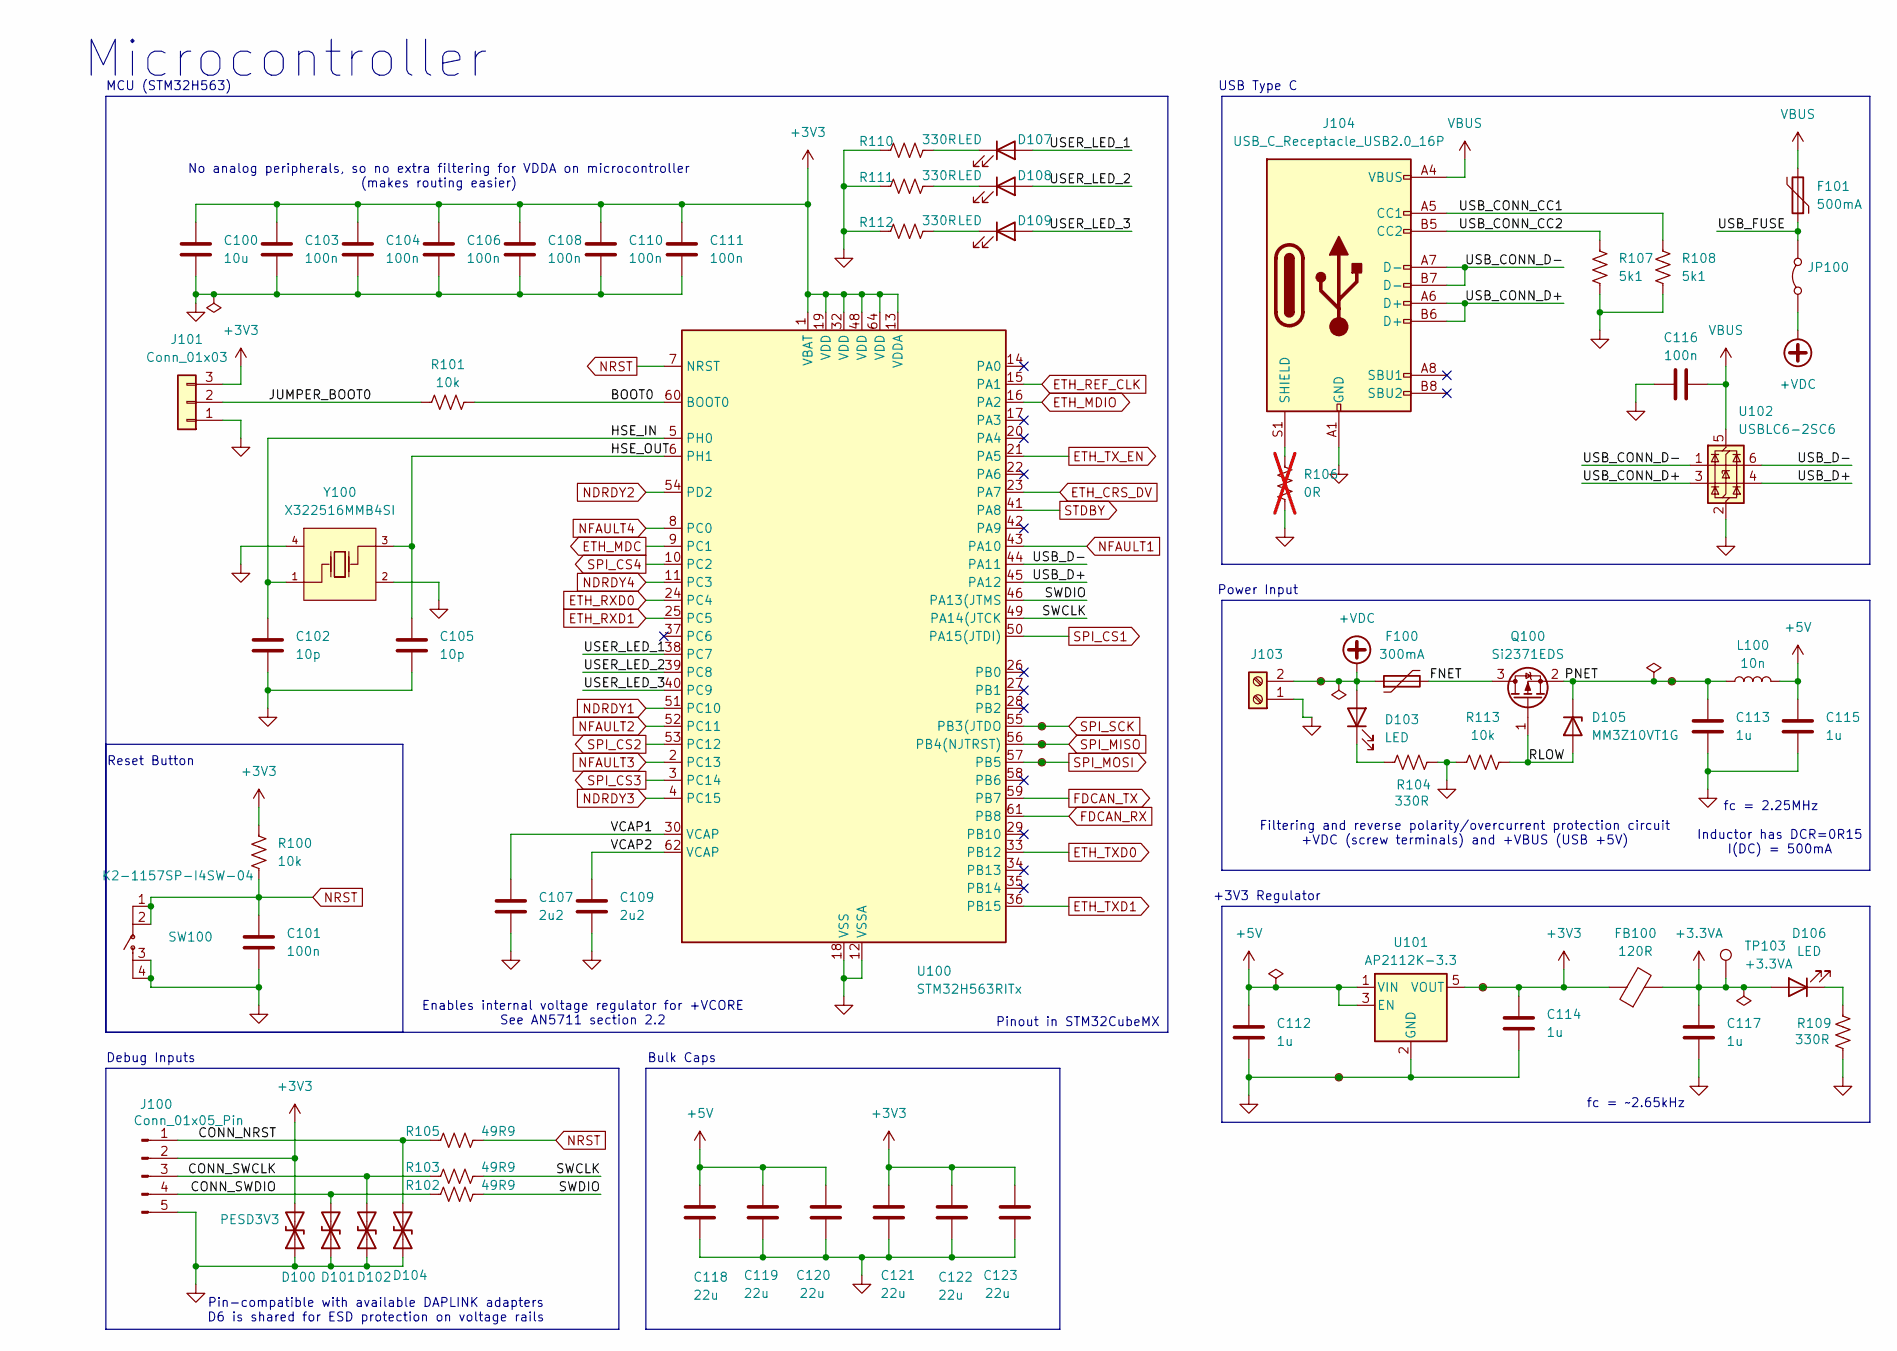
[picture p17: schematic microcontroller.kicad_sch, Thermocouple Board]

Parts:
C100: 10u; C_0603_1608Metric; LCSC C19702
C101, C103, C104, C106, C108, C110, C111, C116: 100n; C_0402_1005Metric; LCSC C1525
C102, C105: 10p; C_0402_1005Metric; LCSC C32949
C107, C109: 2u2; C_0402_1005Metric; LCSC C170151
C112, C113, C114, C115, C117: 1u; C_0603_1608Metric; LCSC C15849
C118, C119, C120, C121, C122, C123: 22u; C_0805_2012Metric; LCSC C602037
D100, D101, D102, D104: PESD3V3; D_SOD-323; LCSC C51450
D103, D106, D107, D108, D109: LED; LED_0402_1005Metric; LCSC C965793
D105: MM3Z10VT1G; D_SOD-323; LCSC C39057
F100: 300mA; C_0603_1608Metric; LCSC C19193027
F101: 500mA; C_0603_1608Metric; LCSC C883095
FB100: 120R; C_0603_1608Metric; LCSC C41330
J100: Conn_01x05_Pin; PinHeader_1x05_P2.54mm_Vertical; LCSC C2337
J101: Conn_01x03; PinHeader_1x03_P2.54mm_Vertical; LCSC C2337
J103: Screw_Terminal_01x02; TerminalBlock_Phoenix_MPT-0,5-2-2.54_1x02_P2.54mm_Horizontal; LCSC C3029316
J104: USB_C_Receptacle_USB2.0_16P; USB_C_Receptacle_HRO_TYPE-C-31-M-12; LCSC C165948
JP100: Jumper_2_Bridged; PinHeader_1x02_P2.54mm_Vertical; LCSC C2337
L100: 10n; L_0603_1608Metric; LCSC C1589
Q100: Si2371EDS; SOT-23; LCSC C467897
R100, R101, R113: 10k; R_0402_1005Metric; LCSC C60490
R102, R103, R105: 49R9; R_0402_1005Metric; LCSC C87044
R104, R109, R110, R111, R112: 330R; R_0402_1005Metric; LCSC C105875
R106: 0R; R_0402_1005Metric; LCSC C106231; not fitted
R107, R108: 5k1; R_0402_1005Metric; LCSC C105873
SW100: K2-1157SP-I4SW-04; SW-SMD_4P-L6.2-W6.2-P4.50-LS8.6; LCSC C2909692
TP100, TP101, TP102, TP104, TP105, TP111, TP112: TestPoint_Small; TestPoint_Pad_D1.0mm
TP103: +3.3VA; TestPoint_Pad_D1.5mm
U100: STM32H563RITx; LQFP-64_10x10mm_P0.5mm; LCSC C20619634
U101: AP2112K-3.3; SOT-23-5; LCSC C51118
U102: USBLC6-2SC6; SOT-23-6; LCSC C7519
Y100: X322516MMB4SI; CRYSTAL-SMD_4P-L2.0-W1.6-BL; LCSC C112972

Connections:
+3.3VA: C117.1, D106.2 (A), FB100.2, TP103.1; also elsewhere on the board
+3V3: C100.1, C103.1, C104.1, C106.1, C108.1, C110.1, C111.1, C114.1, C121.2, C122.2, C123.2, D100.2 (A2), FB100.1, J100.2, J101.3, R100.1, TP102.1, U100.1 (VBAT), U100.13 (VDDA), U100.19 (VDD), U100.32 (VDD), U100.48 (VDD), U100.64 (VDD), U101.5 (VOUT); also elsewhere on the board
+5V: C112.1, C115.1, C118.2, C119.2, C120.2, L100.2, U101.1 (VIN), U101.3 (EN); also elsewhere on the board
+VDC: D103.2 (A), F100.1, J103.2, JP100.1 (A), TP101.1
/Microcontroller/BOOT0: R101.2, U100.60 (BOOT0)
/Microcontroller/CONN_NRST: D104.2 (A2), J100.1, R105.1
/Microcontroller/CONN_SWCLK: D102.2 (A2), J100.3, R103.1
/Microcontroller/CONN_SWDIO: D101.2 (A2), J100.4, R102.1
/Microcontroller/FNET: F100.2, Q100.3 (D)
/Microcontroller/HSE_IN: C102.1, U100.5 (PH0), Y100.1
/Microcontroller/HSE_OUT: C105.1, U100.6 (PH1), Y100.3
/Microcontroller/JUMPER_BOOT0: J101.2, R101.1
/Microcontroller/PNET: C113.1, D105.1 (K), L100.1, Q100.2 (S), TP111.1
/Microcontroller/RLOW: D105.2 (A), Q100.1 (G), R113.2
/Microcontroller/SWCLK: R103.2, U100.49 (PA14(JTCK)
/Microcontroller/SWDIO: R102.2, U100.46 (PA13(JTMS)
/Microcontroller/USB_CONN_CC1: J104.A5 (CC1), R108.1
/Microcontroller/USB_CONN_CC2: J104.B5 (CC2), R107.1
/Microcontroller/USB_CONN_D+: J104.A6 (D+), J104.B6 (D+), U102.3 (I/O2)
/Microcontroller/USB_CONN_D-: J104.A7 (D-), J104.B7 (D-), U102.1 (I/O1)
/Microcontroller/USB_D+: U100.45 (PA12), U102.4 (I/O2)
/Microcontroller/USB_D-: U100.44 (PA11), U102.6 (I/O1)
/Microcontroller/USB_FUSE: F101.1, JP100.2 (B)
/Microcontroller/USER_LED_1: D107.2 (A), U100.38 (PC7)
/Microcontroller/USER_LED_2: D108.2 (A), U100.39 (PC8)
/Microcontroller/USER_LED_3: D109.2 (A), U100.40 (PC9)
/Microcontroller/VCAP1: C107.1, U100.30 (VCAP)
/Microcontroller/VCAP2: C109.1, U100.62 (VCAP)
ETH_CRS_DV: U100.23 (PA7); also elsewhere on the board
ETH_MDC: U100.9 (PC1); also elsewhere on the board
ETH_MDIO: U100.16 (PA2); also elsewhere on the board
ETH_REF_CLK: U100.15 (PA1); also elsewhere on the board
ETH_RXD0: U100.24 (PC4); also elsewhere on the board
ETH_RXD1: U100.25 (PC5); also elsewhere on the board
ETH_TXD0: U100.33 (PB12); also elsewhere on the board
ETH_TXD1: U100.36 (PB15); also elsewhere on the board
ETH_TX_EN: U100.21 (PA5); also elsewhere on the board
FDCAN_RX: U100.61 (PB8); also elsewhere on the board
FDCAN_TX: U100.59 (PB7); also elsewhere on the board
GND: C100.2, C101.2, C102.2, C103.2, C104.2, C105.2, C106.2, C107.2, C108.2, C109.2, C110.2, C111.2, C112.2, C113.2, C114.2, C115.2, C116.1, C117.2, C118.1, C119.1, C120.1, C121.1, C122.1, C123.1, D100.1 (A1), D101.1 (A1), D102.1 (A1), D104.1 (A1), J100.5, J101.1, J103.1, J104.A1 (GND), J104.A12 (GND), J104.B1 (GND), J104.B12 (GND), R104.2, R106.2, R107.2, R108.2, R109.2, R110.1, R111.1, R112.1, R113.1, SW100.3, SW100.4, TP112.1, U100.12 (VSSA), U100.18 (VSS), U100.31 (VSS), U100.47 (VSS), U100.63 (VSS), U101.2 (GND), U102.2 (GND), Y100.2, Y100.4; also elsewhere on the board
NDRDY1: U100.51 (PC10); also elsewhere on the board
NDRDY2: U100.54 (PD2); also elsewhere on the board
NDRDY3: U100.4 (PC15); also elsewhere on the board
NDRDY4: U100.11 (PC3); also elsewhere on the board
NFAULT1: U100.43 (PA10); also elsewhere on the board
NFAULT2: U100.52 (PC11); also elsewhere on the board
NFAULT3: U100.2 (PC13); also elsewhere on the board
NFAULT4: U100.8 (PC0); also elsewhere on the board
NRST: C101.1, R100.2, R105.2, SW100.1, SW100.2, U100.7 (NRST); also elsewhere on the board
unnamed: D103.1 (K), R104.1
unnamed: D106.1 (K), R109.1
unnamed: D107.1 (K), R110.2
unnamed: D108.1 (K), R111.2
unnamed: D109.1 (K), R112.2
unnamed: J104.S1 (SHIELD), R106.1
SPI_CS1: U100.50 (PA15(JTDI)); also elsewhere on the board
SPI_CS2: U100.53 (PC12); also elsewhere on the board
SPI_CS3: U100.3 (PC14); also elsewhere on the board
SPI_CS4: U100.10 (PC2); also elsewhere on the board
SPI_MISO: TP104.1, U100.56 (PB4(NJTRST)); also elsewhere on the board
SPI_MOSI: TP105.1, U100.57 (PB5); also elsewhere on the board
SPI_SCK: TP100.1, U100.55 (PB3(JTDO); also elsewhere on the board
STDBY: U100.41 (PA8); also elsewhere on the board
VBUS: C116.2, F101.2, J104.A4 (VBUS), J104.A9 (VBUS), J104.B4 (VBUS), J104.B9 (VBUS), U102.5 (VBUS)

Notes on the sheet:
fc = 2.25MHz
Microcontroller
Reset Button
Debug Inputs
Power Input
fc = ~2.65kHz
Inductor has DCR=0R15 I(DC) = 500mA
+3V3 Regulator
Pinout in STM32CubeMX
Pin-compatible with available DAPLINK adapters D6 is shared for ESD protection on voltage rails
Enables internal voltage regulator for +VCORE See AN5711 section 2.2
No analog peripherals, so no extra filtering for VDDA on microcontroller (makes routing easier)
Bulk Caps
Filtering and reverse polarity/overcurrent protection circuit +VDC (screw terminals) and +VBUS (USB +5V)
USB Type C
MCU (STM32H563)

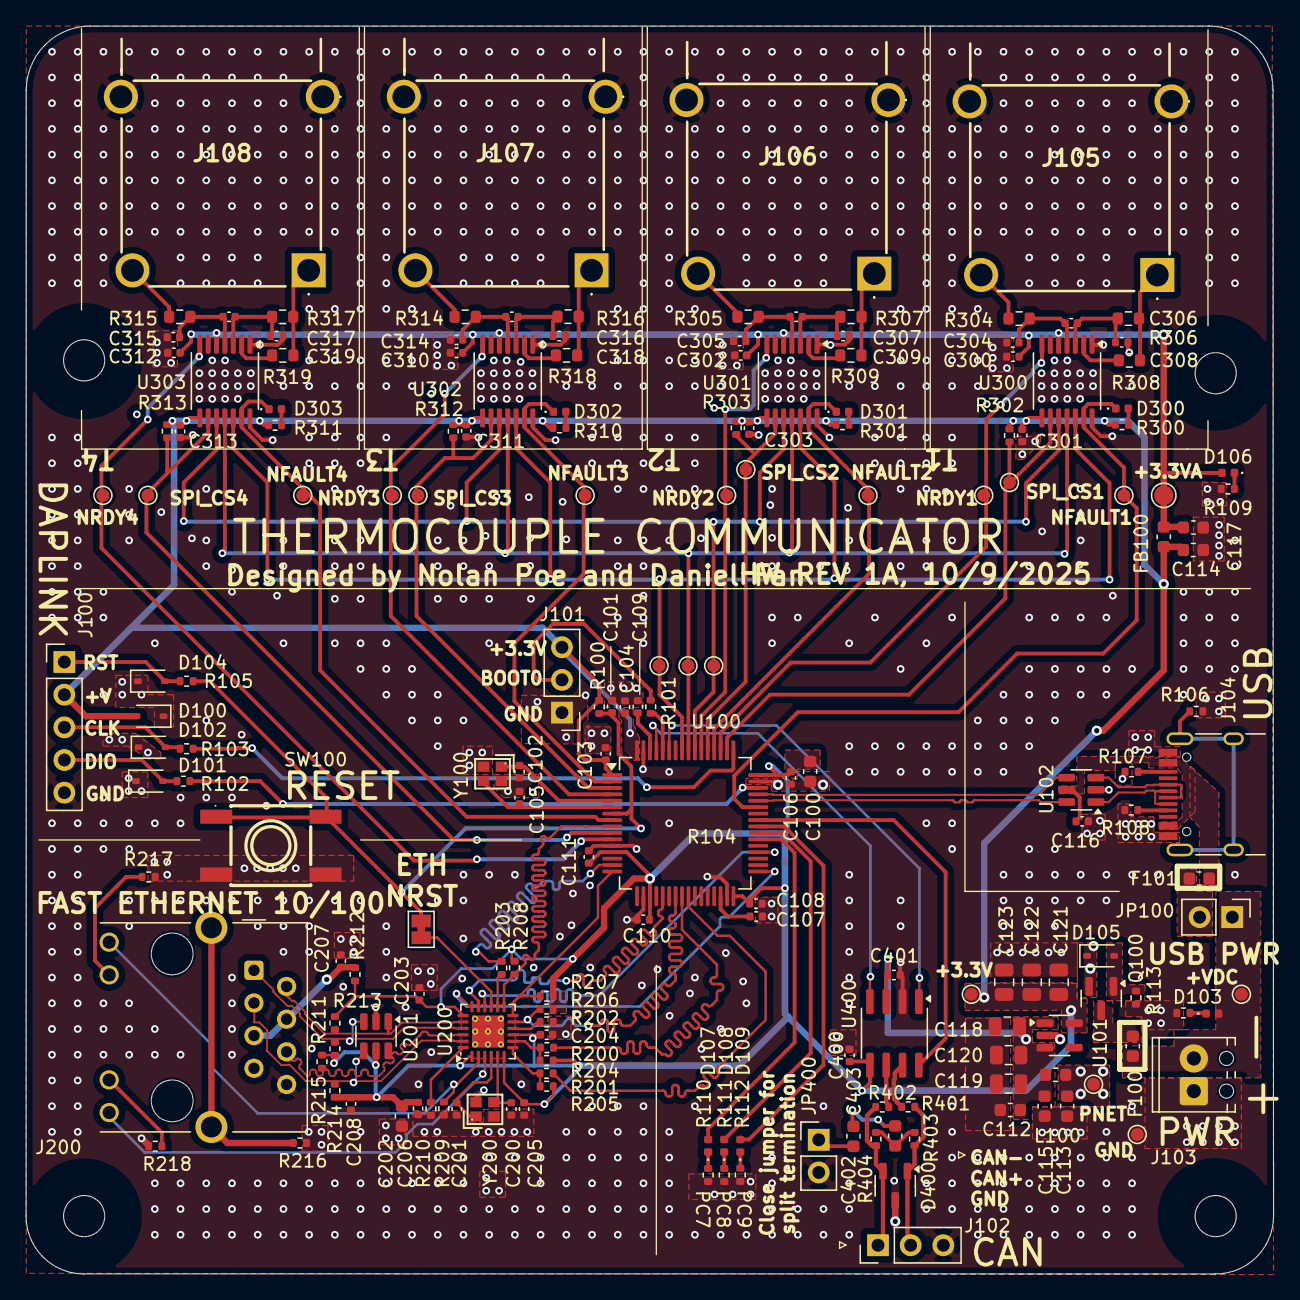
[picture p18: board ThermoBoard.kicad_pcb from above]

Board: 4 copper layers, 97.0 x 97.0 mm, 184 parts (0 on the bottom side), 113 nets.
