npgo22/ThermoBoard/stm32cubemx/stm32cubemx.ioc

Mcu.UserName=STM32H563RITx
PA1.Signal=ETH_REF_CLK
PA10.Signal=GPIO_Input
PA11.Signal=USB_DM
PA12.Signal=USB_DP
PA13(JTMS/SWDIO).Signal=DEBUG_JTMS-SWDIO
PA14(JTCK/SWCLK).Signal=DEBUG_JTCK-SWCLK
PA15(JTDI).Signal=GPIO_Output
PA2.Signal=ETH_MDIO
PA5.Signal=ETH_TX_EN
PA7.Signal=ETH_CRS_DV
PA8.Signal=GPIO_Output
PB12.Signal=ETH_TXD0
PB15.Signal=ETH_TXD1
PB3(JTDO/TRACESWO).Signal=SPI1_SCK
PB4(NJTRST).Signal=SPI1_MISO
PB5.Signal=SPI1_MOSI
PB7.Signal=FDCAN1_TX
PB8.Signal=FDCAN1_RX
PC0.Signal=GPIO_Input
PC1.Signal=ETH_MDC
PC10.Signal=GPIO_Input
PC11.Signal=GPIO_Input
PC12.Signal=GPIO_Output
PC13.Signal=GPIO_Input
PC14-OSC32_IN(OSC32_IN).Signal=GPIO_Output
PC15-OSC32_OUT(OSC32_OUT).Signal=GPIO_Input
PC2.Signal=GPIO_Output
PC3.Signal=GPIO_Input
PC4.Signal=ETH_RXD0
PC5.Signal=ETH_RXD1
PC7.Signal=GPIO_Output
PC8.Signal=GPIO_Output
PC9.Signal=GPIO_Output
PD2.Signal=GPIO_Input
PH0-OSC_IN(PH0).Signal=RCC_OSC_IN
PH1-OSC_OUT(PH1).Signal=RCC_OSC_OUT
