npgo22/ThermoBoard/(commit log)

2025-10-07 Add schematic
2025-10-07 A4 -> USLetter sheets
    [can.kicad_sch]
2025-10-08 Footprints added
    [ThermoBoard.kicad_pcb, can.kicad_sch, ethernet.kicad_sch, microcontroller.kicad_sch, thermocouples.kicad_sch]
2025-10-08 Some changes to power circuitry, more layout
    [ThermoBoard.kicad_pcb, can.kicad_sch, ethernet.kicad_sch, microcontroller.kicad_sch, thermocouples.kicad_sch]
2025-10-08 Some more schematic updates
    [ThermoBoard.kicad_pcb]
2025-10-08 Extremely incomplete, preliminary, pre-alpha, ugly layout
    [ThermoBoard.kicad_pcb, ThermoBoard.kicad_sch, can.kicad_sch, ethernet.kicad_sch, microcontroller.kicad_sch, thermocouples.kicad_sch]
2025-10-08 First decent layout
    [ThermoBoard.kicad_pcb, ThermoBoard.kicad_sch, ethernet.kicad_sch, microcontroller.kicad_sch, thermocouples.kicad_sch]
2025-10-08 Better plots, make the fuse really obvious
    [ThermoBoard.kicad_pcb]
2025-10-08 Actually Pre-via
    [ThermoBoard.kicad_pcb]
2025-10-09 I hate everything
    [ThermoBoard.kicad_pcb, ThermoBoard.kicad_sch, can.kicad_sch, ethernet.kicad_sch, microcontroller.kicad_sch, thermocouples.kicad_sch]
2025-10-09 First workable layout
    [BOM-ThermoBoard.csv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]
2025-10-09 Added pfet for reverse polarity protection, moved power circuitry away from analog parts
    [CPL-ThermoBoard.csv, ThermoBoard-CuBottom.gbr, ThermoBoard-CuIn1.gbr, ThermoBoard-CuIn2.gbr, ThermoBoard-CuTop.gbr, ThermoBoard-EdgeCuts.gbr, ThermoBoard-MaskBottom.gbr, ThermoBoard-MaskTop.gbr]
2025-10-10 Apply Daniel's suggestions
    [ThermoBoard.kicad_pcb, ThermoBoard.kicad_sch, microcontroller.kicad_sch]
2025-10-10 Modify repo for usage on Linux, add basic CI
    chore: fix CI
    Small things
    [BOM-ThermoBoard.csv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]
2025-10-10 Silkscreen stuff
    [microcontroller.kicad_sch]
2025-10-10 Swap to ESD204 for ethernet to enable better routing
    [BOM-ThermoBoard.csv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]
2025-10-10 Fix major ethernet silkscreen placement and re-add DRC rules
